johnglennII/Tomato-Harvester/cad/assembly/Arm Plate v2.SLDPRT

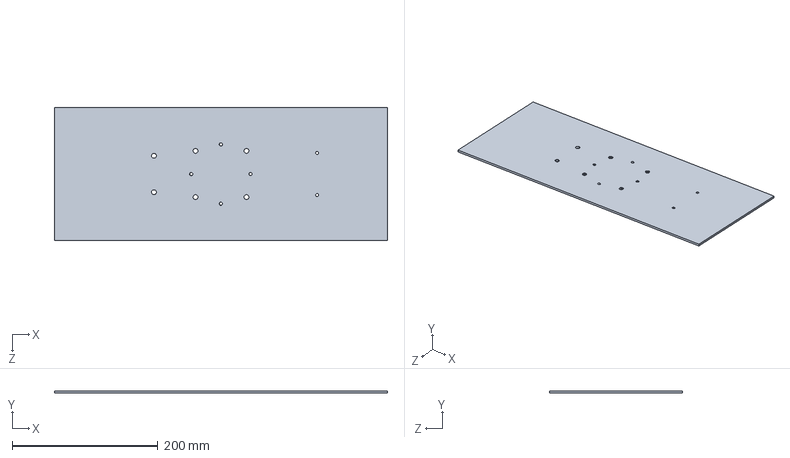
[picture p8: CAD file, 2026-05-16]
cad/assembly/Arm Plate v2.SLDPRT
457.2 x 3.18 x 182.6 mm
