johnglennII/Tomato-Harvester/cad/assembly/2525 Length=SupportH.SLDPRT

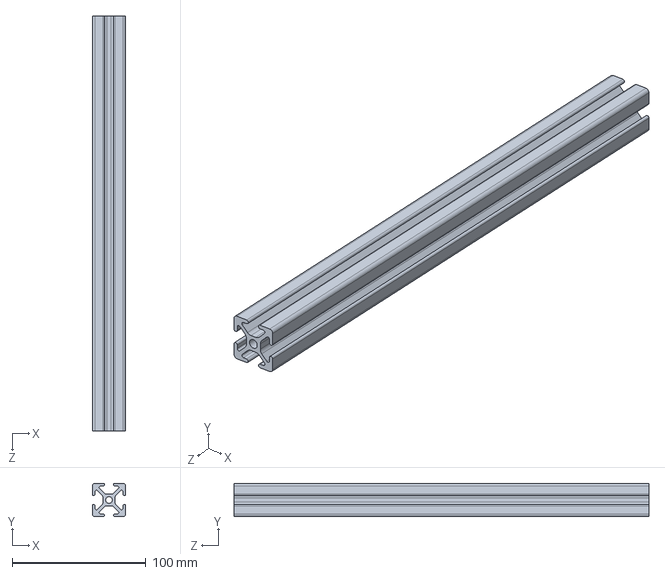
[picture p9: CAD file, 2026-05-16]
cad/assembly/2525 Length=SupportH.SLDPRT
25.0 x 25.0 x 310.8 mm
