johnglennII/Tomato-Harvester/cad/assembly/Turntable Support.SLDPRT

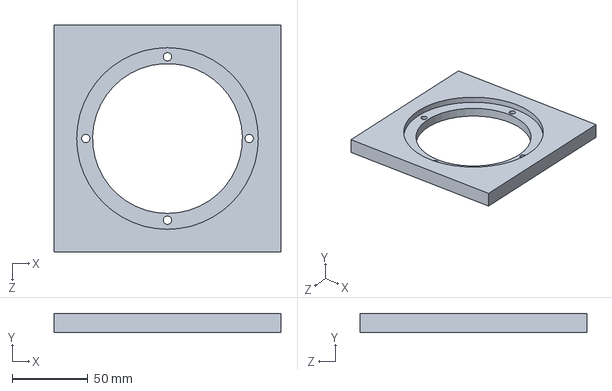
[picture p10: CAD file, 2026-05-16]
cad/assembly/Turntable Support.SLDPRT
150.0 x 12.6 x 150.0 mm
