johnglennII/Tomato-Harvester/cad/assembly/Phi Motor Support.SLDPRT

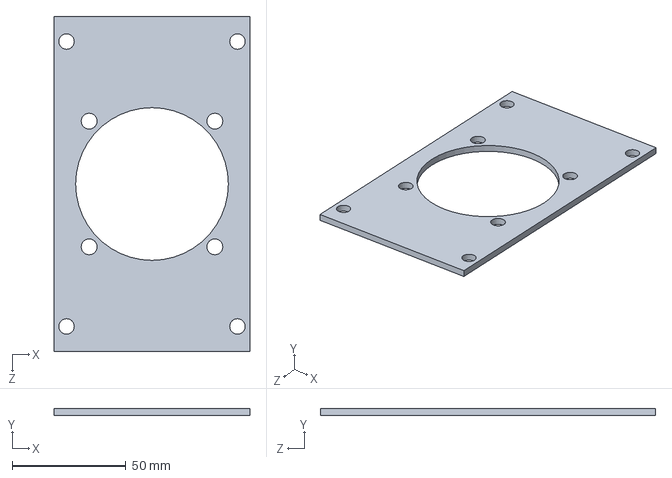
[picture p11: CAD file, 2026-05-16]
cad/assembly/Phi Motor Support.SLDPRT
86.0 x 3.17 x 147.0 mm
