johnglennII/Tomato-Harvester/cad/assembly/Turntable Bearing Outer.SLDPRT

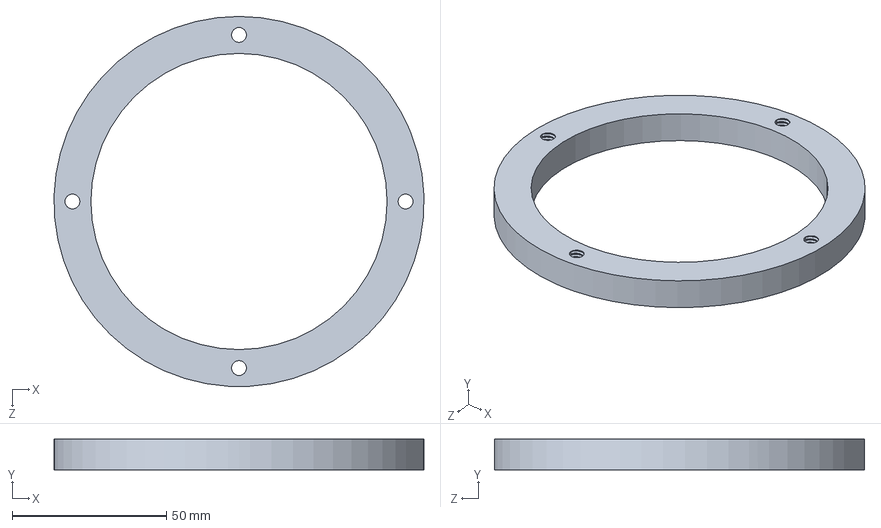
[picture p12: CAD file, 2026-05-16]
cad/assembly/Turntable Bearing Outer.SLDPRT
119.9 x 10.0 x 120.0 mm
