johnglennII/Tomato-Harvester/cad/assembly/Turntable Bearing Inner.SLDPRT

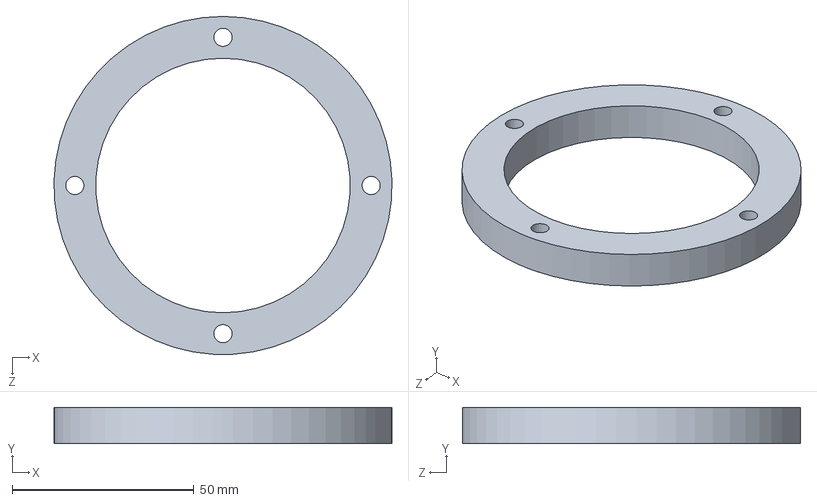
[picture p13: CAD file, 2026-05-16]
cad/assembly/Turntable Bearing Inner.SLDPRT
93.0 x 10.0 x 93.0 mm
