johnglennII/Tomato-Harvester/cad/assembly/Theta Shaft.SLDPRT

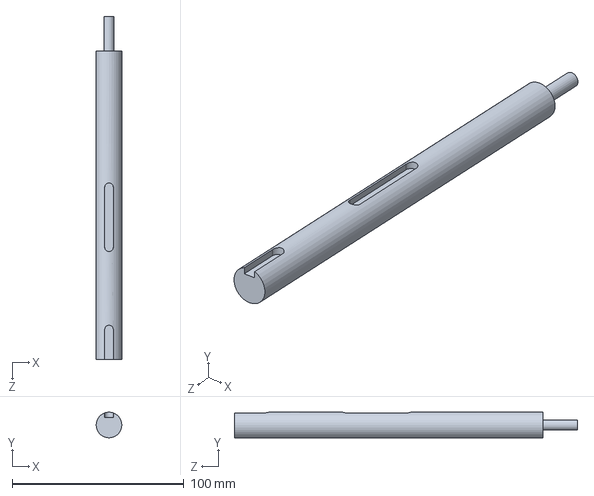
[picture p14: CAD file, 2026-05-16]
cad/assembly/Theta Shaft.SLDPRT
15.0 x 15.0 x 200.0 mm
