johnglennII/Tomato-Harvester/cad/assembly/Bottom Plate v2.SLDPRT

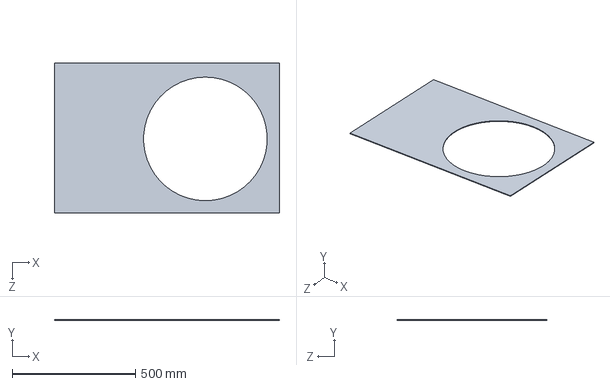
[picture p15: CAD file, 2026-05-16]
cad/assembly/Bottom Plate v2.SLDPRT
914.4 x 3.17 x 609.6 mm
