johnglennII/Tomato-Harvester/cad/assembly/Motor Mount.SLDPRT

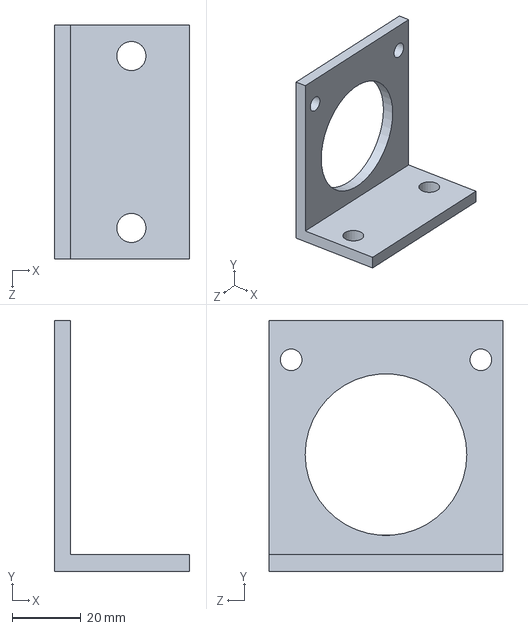
[picture p16: CAD file, 2026-05-16]
cad/assembly/Motor Mount.SLDPRT
39.4 x 73.0 x 68.0 mm
