johnglennII/Tomato-Harvester/cad/assembly/15mm Shaft Coupler.SLDPRT

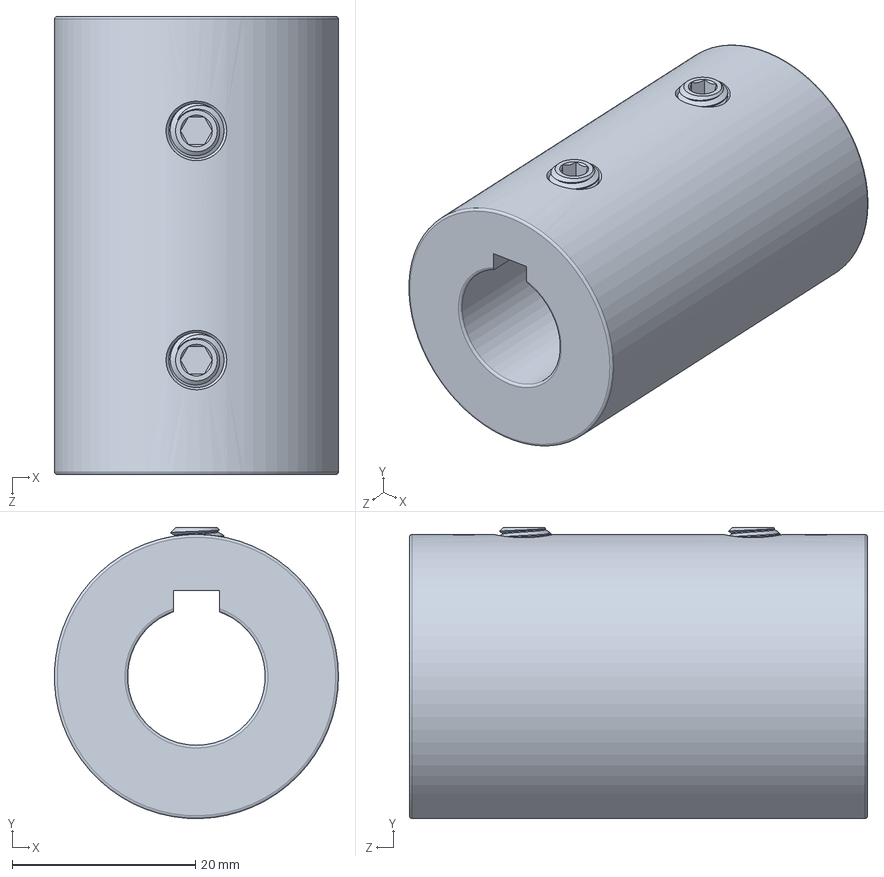
[picture p17: CAD file, 2026-05-16]
cad/assembly/15mm Shaft Coupler.SLDPRT
31.0 x 31.8 x 50.0 mm
