johnglennII/Tomato-Harvester/cad/assembly/Linear Actuator v3.SLDPRT

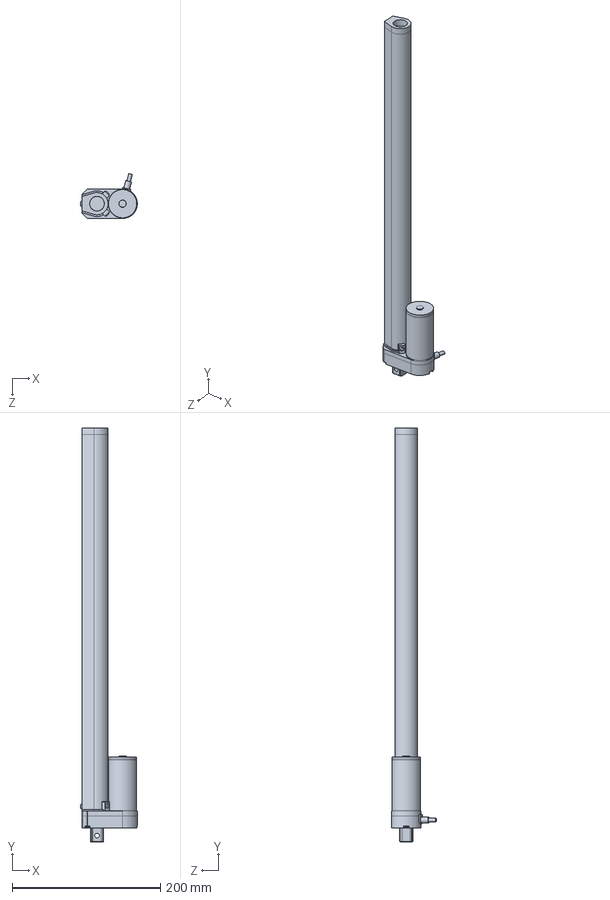
[picture p18: CAD file, 2026-05-16]
cad/assembly/Linear Actuator v3.SLDPRT
76.6 x 558.9 x 60.7 mm
