johnglennII/Tomato-Harvester/cad/assembly/Cytron MD10C R3.SLDPRT

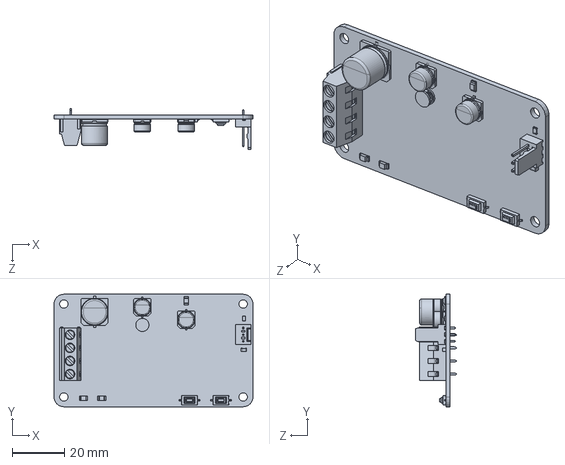
[picture p19: CAD file, 2026-05-16]
cad/assembly/Cytron MD10C R3.SLDPRT
76.0 x 43.0 x 15.7 mm
