johnglennII/Tomato-Harvester/cad/assembly/Motor Driver Box.SLDPRT

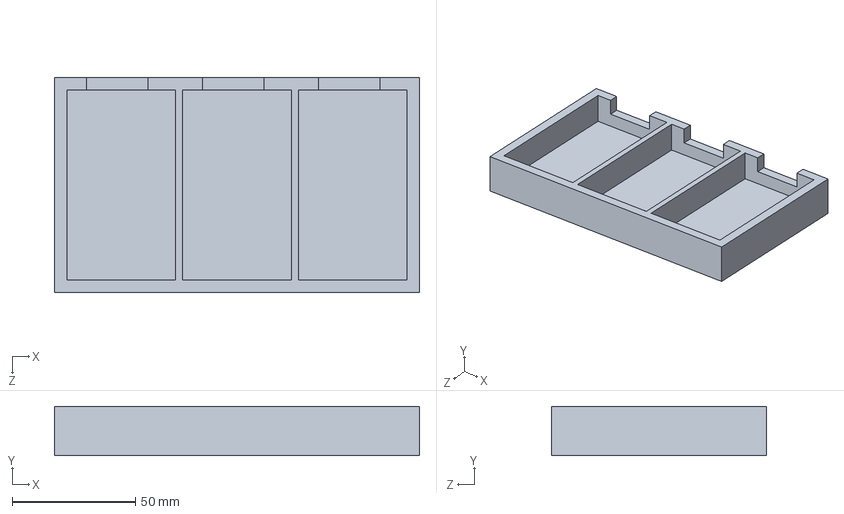
[picture p20: CAD file, 2026-05-15]
cad/assembly/Motor Driver Box.SLDPRT
148.0 x 20.0 x 87.0 mm
