johnglennII/Tomato-Harvester/cad/assembly/DC Motor 2 v2.SLDPRT

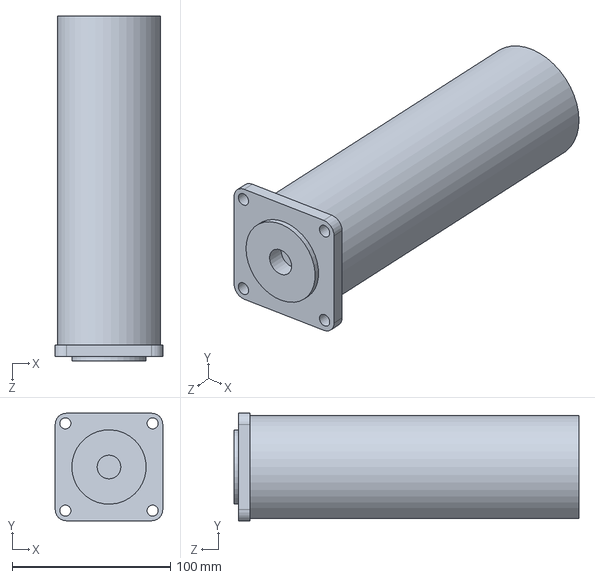
[picture p21: CAD file, 2026-05-15]
cad/assembly/DC Motor 2 v2.SLDPRT
68.0 x 68.0 x 218.0 mm
