johnglennII/Tomato-Harvester/cad/assembly/Actuator Adapter.SLDPRT

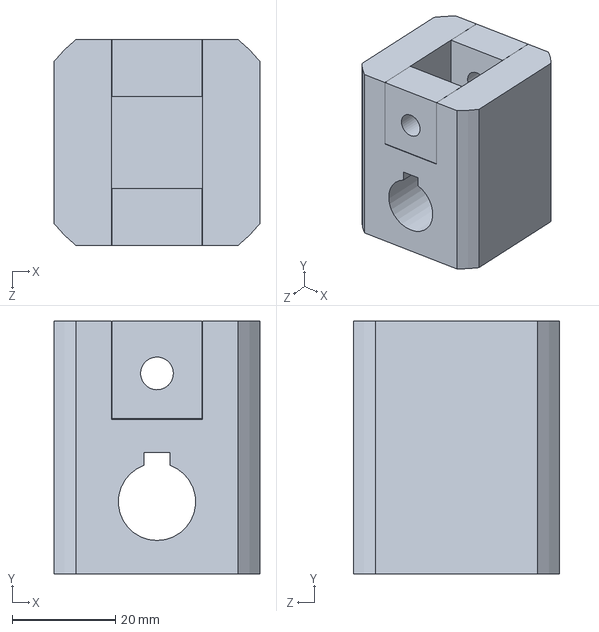
[picture p22: CAD file, 2026-05-15]
cad/assembly/Actuator Adapter.SLDPRT
39.9 x 49.0 x 39.9 mm
