johnglennII/Tomato-Harvester/cad/assembly/DC Motor Shaft 2 v2.SLDPRT

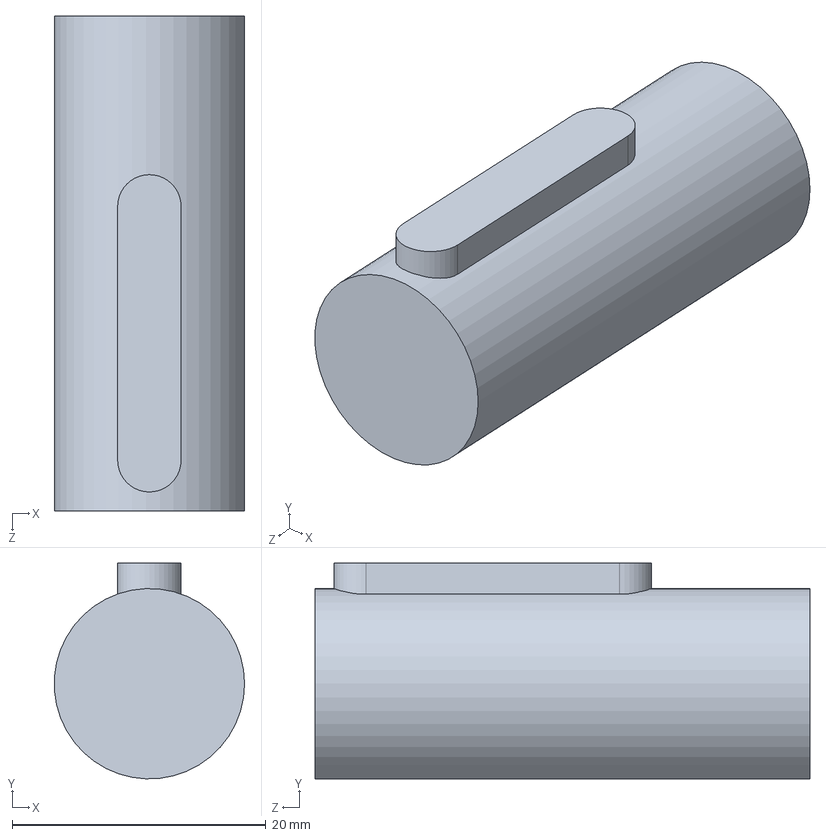
[picture p23: CAD file, 2026-05-15]
cad/assembly/DC Motor Shaft 2 v2.SLDPRT
15.0 x 17.0 x 39.0 mm
