johnglennII/Tomato-Harvester/cad/assembly/Draw Wire Encoder.SLDPRT

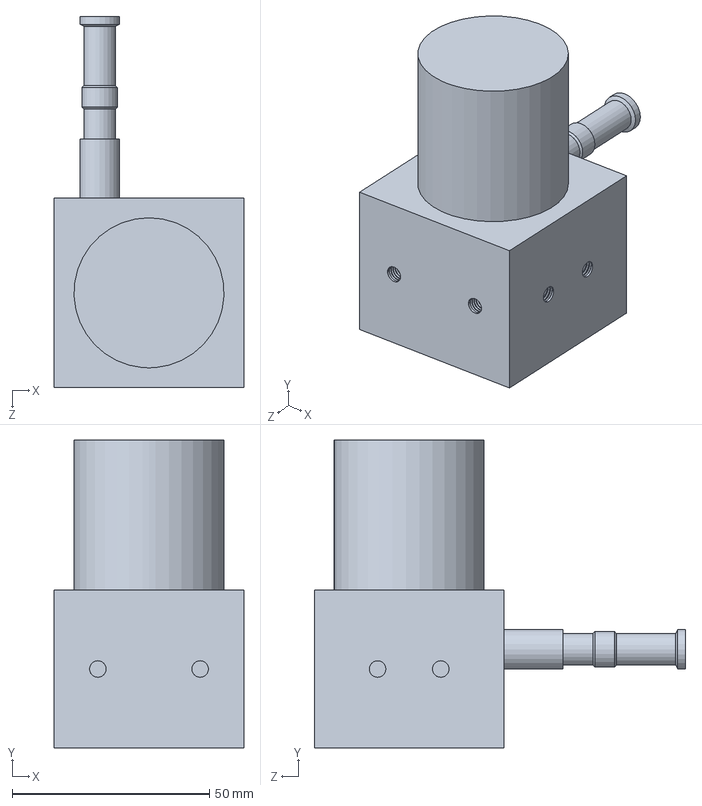
[picture p24: CAD file, 2026-05-15]
cad/assembly/Draw Wire Encoder.SLDPRT
48.0 x 78.0 x 94.0 mm
