johnglennII/Tomato-Harvester/cad/assembly/Draw Wire Encoder Bracket.SLDPRT

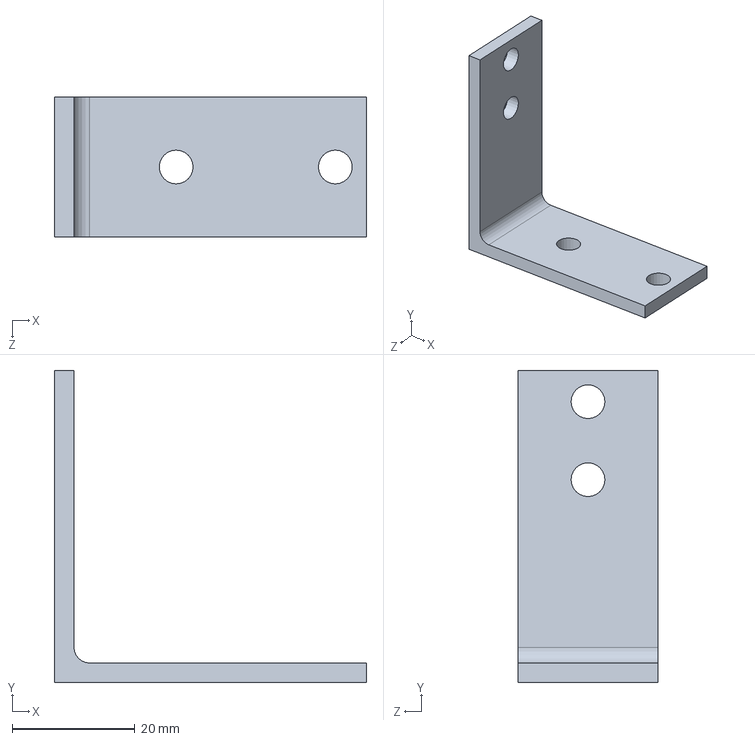
[picture p25: CAD file, 2026-05-15]
cad/assembly/Draw Wire Encoder Bracket.SLDPRT
50.8 x 50.8 x 22.9 mm
