johnglennII/Tomato-Harvester/cad/assembly/Breakout Board Box.SLDPRT

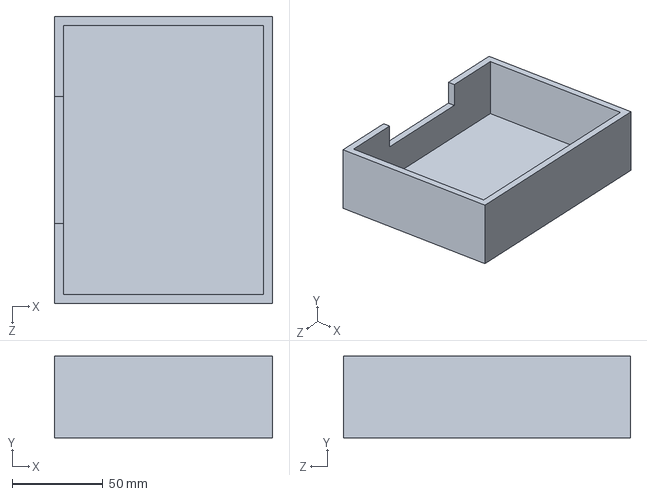
[picture p26: CAD file, 2026-05-15]
cad/assembly/Breakout Board Box.SLDPRT
120.0 x 45.0 x 158.0 mm
