johnglennII/Tomato-Harvester/cad/assembly/Phi Shaft.SLDPRT

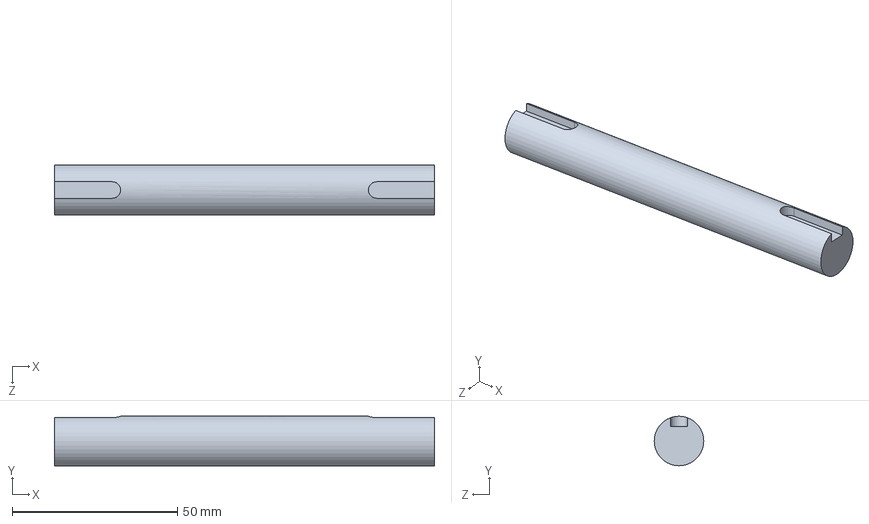
[picture p27: CAD file, 2026-05-15]
cad/assembly/Phi Shaft.SLDPRT
115.0 x 15.0 x 15.0 mm
