johnglennII/Tomato-Harvester/cad/assembly/Machined Shaft Coupler Top.SLDPRT

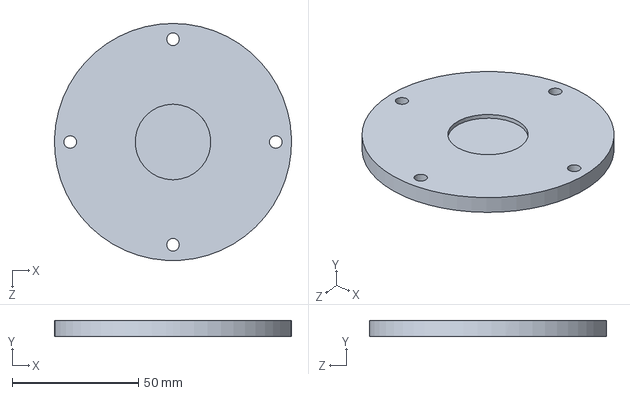
[picture p28: CAD file, 2026-05-15]
cad/assembly/Machined Shaft Coupler Top.SLDPRT
94.0 x 6.35 x 94.0 mm
