johnglennII/Tomato-Harvester/cad/assembly/Hollow Shaft Encoder.SLDPRT

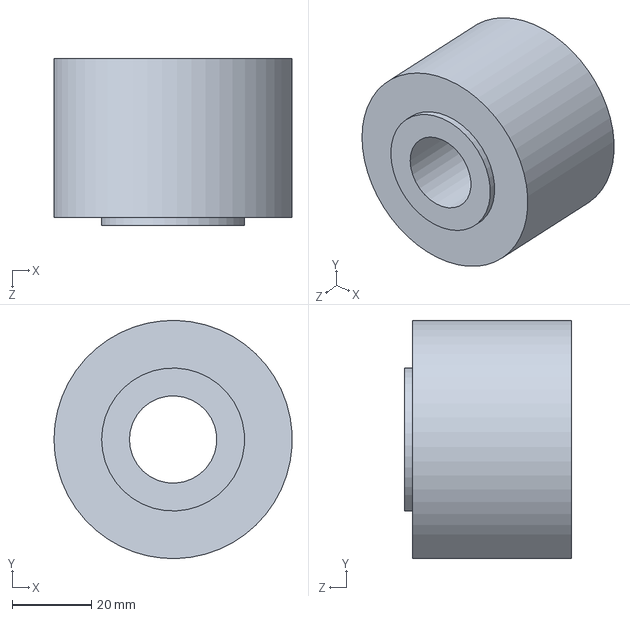
[picture p29: CAD file, 2026-05-15]
cad/assembly/Hollow Shaft Encoder.SLDPRT
59.9 x 60.0 x 42.0 mm
