johnglennII/Tomato-Harvester/cad/assembly/20mm Rounded Key.SLDPRT

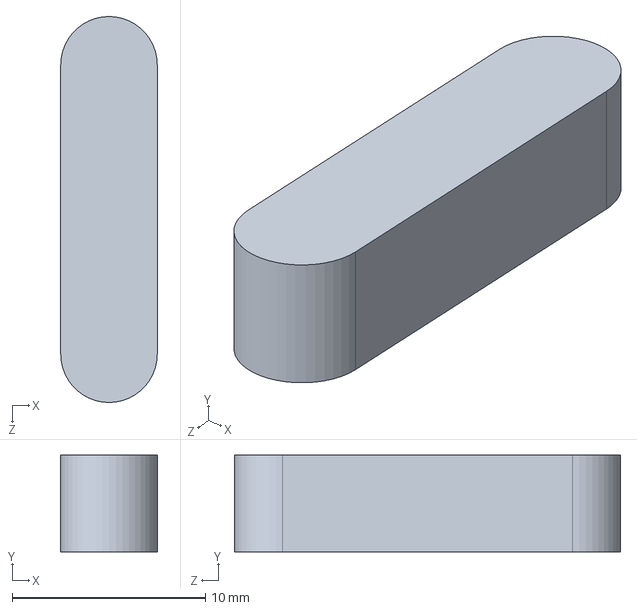
[picture p30: CAD file, 2026-05-15]
cad/assembly/20mm Rounded Key.SLDPRT
5.00 x 5.00 x 20.0 mm
