johnglennII/Tomato-Harvester/cad/assembly/6mm-6mm coupler.SLDPRT

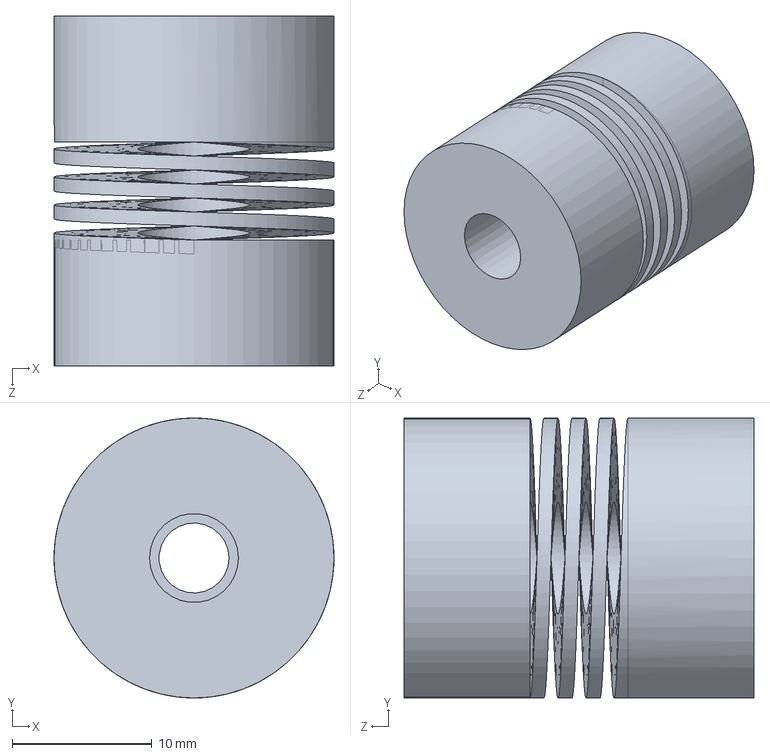
[picture p31: CAD file, 2026-05-15]
cad/assembly/6mm-6mm coupler.SLDPRT
20.0 x 20.0 x 25.0 mm
