johnglennII/Tomato-Harvester/cad/assembly/40mm Rounded Key.SLDPRT

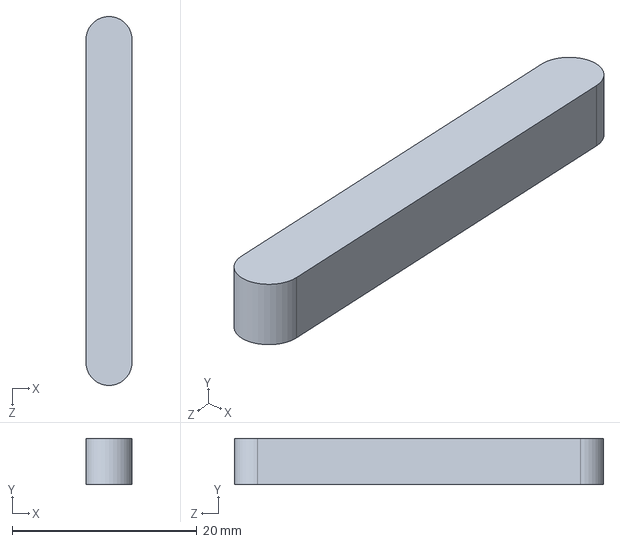
[picture p32: CAD file, 2026-05-15]
cad/assembly/40mm Rounded Key.SLDPRT
5.00 x 5.00 x 40.0 mm
