johnglennII/Tomato-Harvester/cad/assembly/Machined Shaft Coupler Bottom.SLDPRT

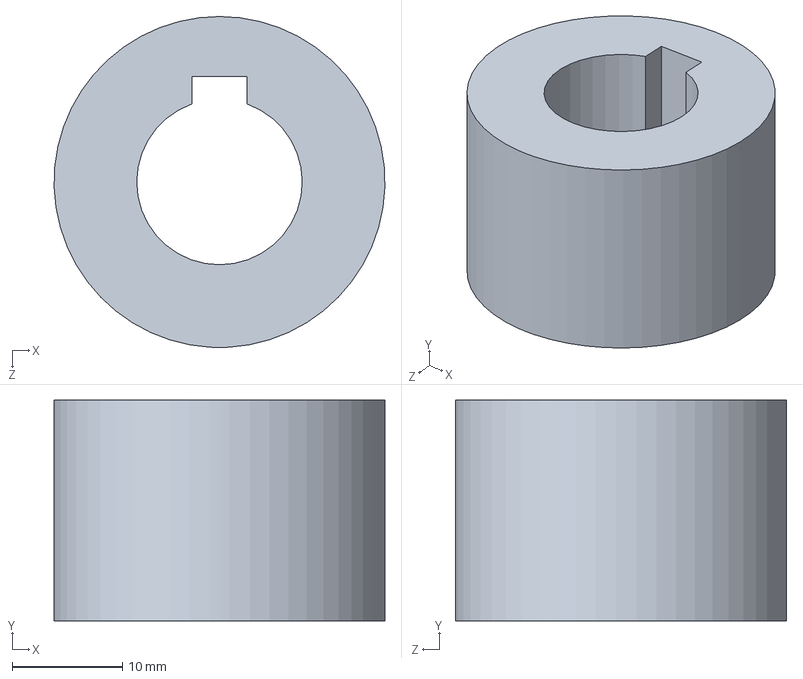
[picture p33: CAD file, 2026-05-15]
cad/assembly/Machined Shaft Coupler Bottom.SLDPRT
30.0 x 20.0 x 30.0 mm
