johnglennII/Tomato-Harvester/cad/assembly/Pillow Block Stand.SLDPRT

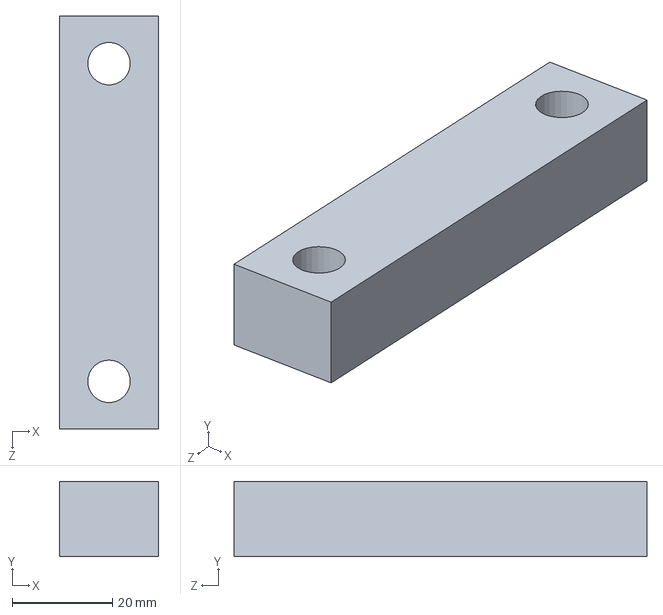
[picture p34: CAD file, 2026-05-15]
cad/assembly/Pillow Block Stand.SLDPRT
19.8 x 15.0 x 82.5 mm
