johnglennII/Tomato-Harvester/cad/assembly/Hollow Shaft.SLDPRT

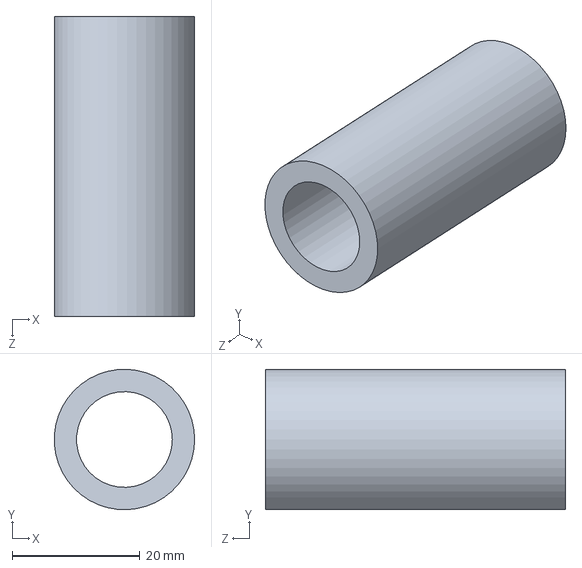
[picture p35: CAD file, 2026-05-15]
cad/assembly/Hollow Shaft.SLDPRT
22.0 x 22.0 x 47.0 mm
