johnglennII/Tomato-Harvester/cad/assembly/Rotary Encoder Housing.SLDPRT

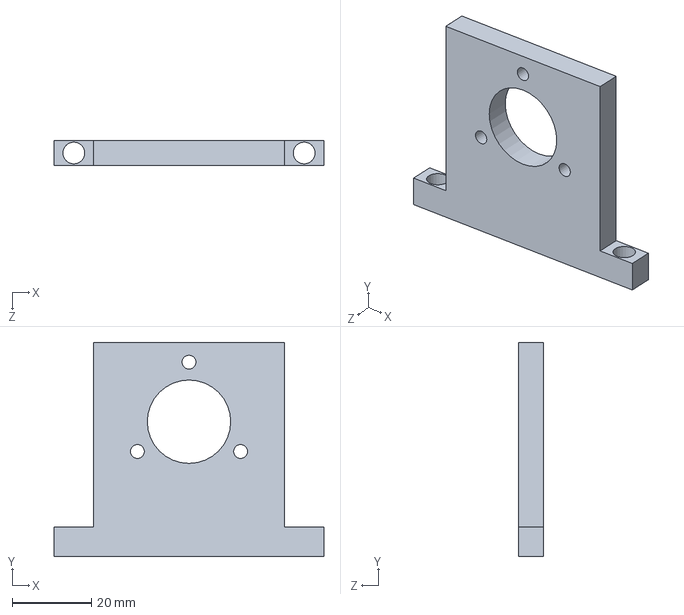
[picture p36: CAD file, 2026-05-15]
cad/assembly/Rotary Encoder Housing.SLDPRT
68.0 x 54.0 x 6.40 mm
