johnglennII/Tomato-Harvester/cad/assembly/Rotary Encoder Shaft v2.SLDPRT

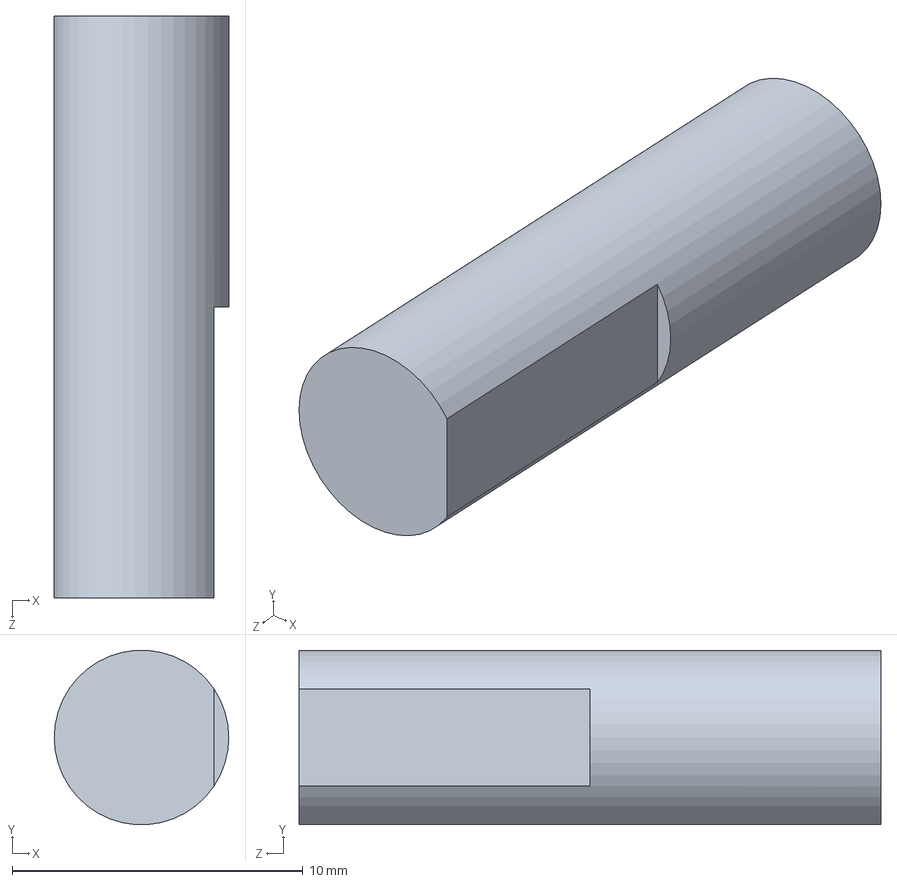
[picture p37: CAD file, 2026-05-15]
cad/assembly/Rotary Encoder Shaft v2.SLDPRT
6.00 x 5.98 x 20.0 mm
