johnglennII/Tomato-Harvester/cad/assembly/Linear Actuator Rod v3.SLDPRT

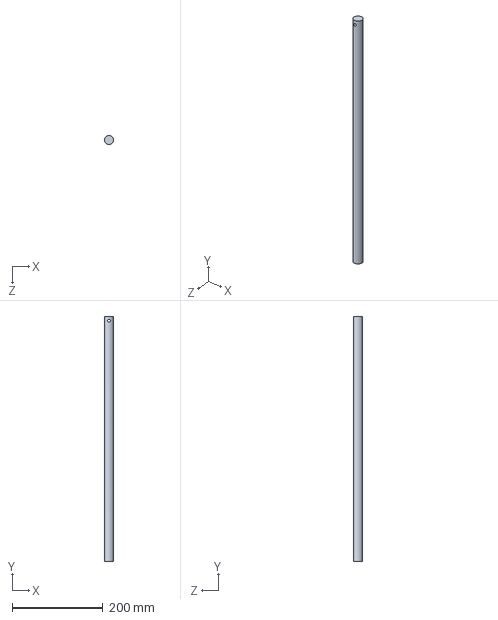
[picture p38: CAD file, 2026-05-15]
cad/assembly/Linear Actuator Rod v3.SLDPRT
19.8 x 539.8 x 19.8 mm
