johnglennII/Tomato-Harvester/cad/assembly/Rotary Encoder v2.SLDPRT

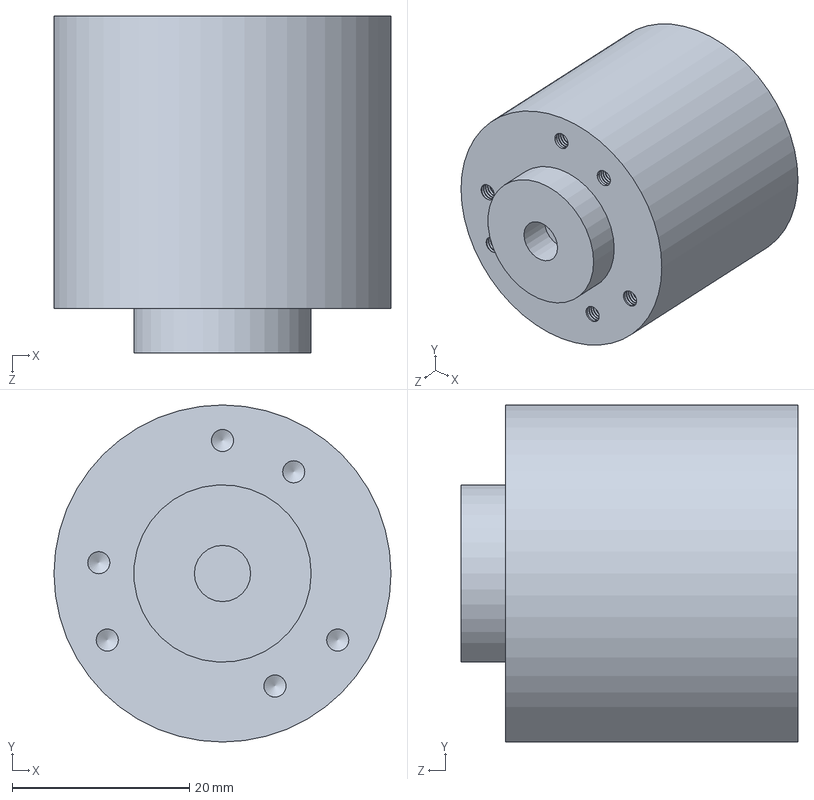
[picture p39: CAD file, 2026-05-15]
cad/assembly/Rotary Encoder v2.SLDPRT
38.0 x 38.0 x 38.0 mm
