johnglennII/Tomato-Harvester/(list of files, cad)

Other CAD files:
cad/assembly/2525 Length=SupportZ.SLDPRT
cad/assembly/2525 Length=BottomPlateX.SLDPRT
cad/assembly/2525 Length=Height.SLDPRT
cad/assembly/2525 Length=BottomPlateZ.SLDPRT
cad/assembly/Corner Bracket.SLDPRT
cad/assembly/2820T56_Dry-Running Mounted Sleeve Bearing.SLDPRT
cad/assembly/M3x0.5-12.SLDPRT
cad/assembly/M5x0.8-10.SLDPRT
cad/assembly/M5x0.8-18.SLDPRT
cad/assembly/M7 Nut.SLDPRT
cad/assembly/M7x1-20.SLDPRT
cad/assembly/M8x1.25-25.SLDPRT
