johnglennII/Tomato-Harvester/media/cad_assembly_1.png

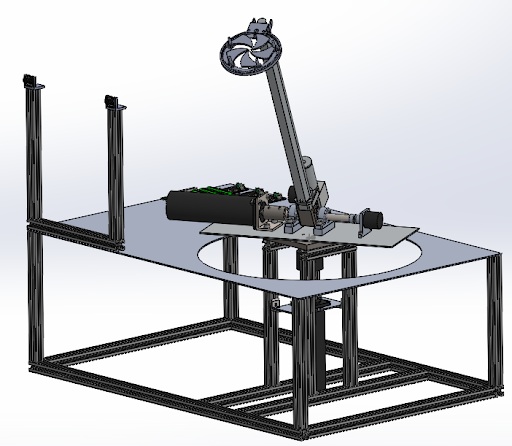
media/cad_assembly_1.png
