johnglennII/Tomato-Harvester/docs/harvester_scratchwork.pdf

I F

m | mi | -

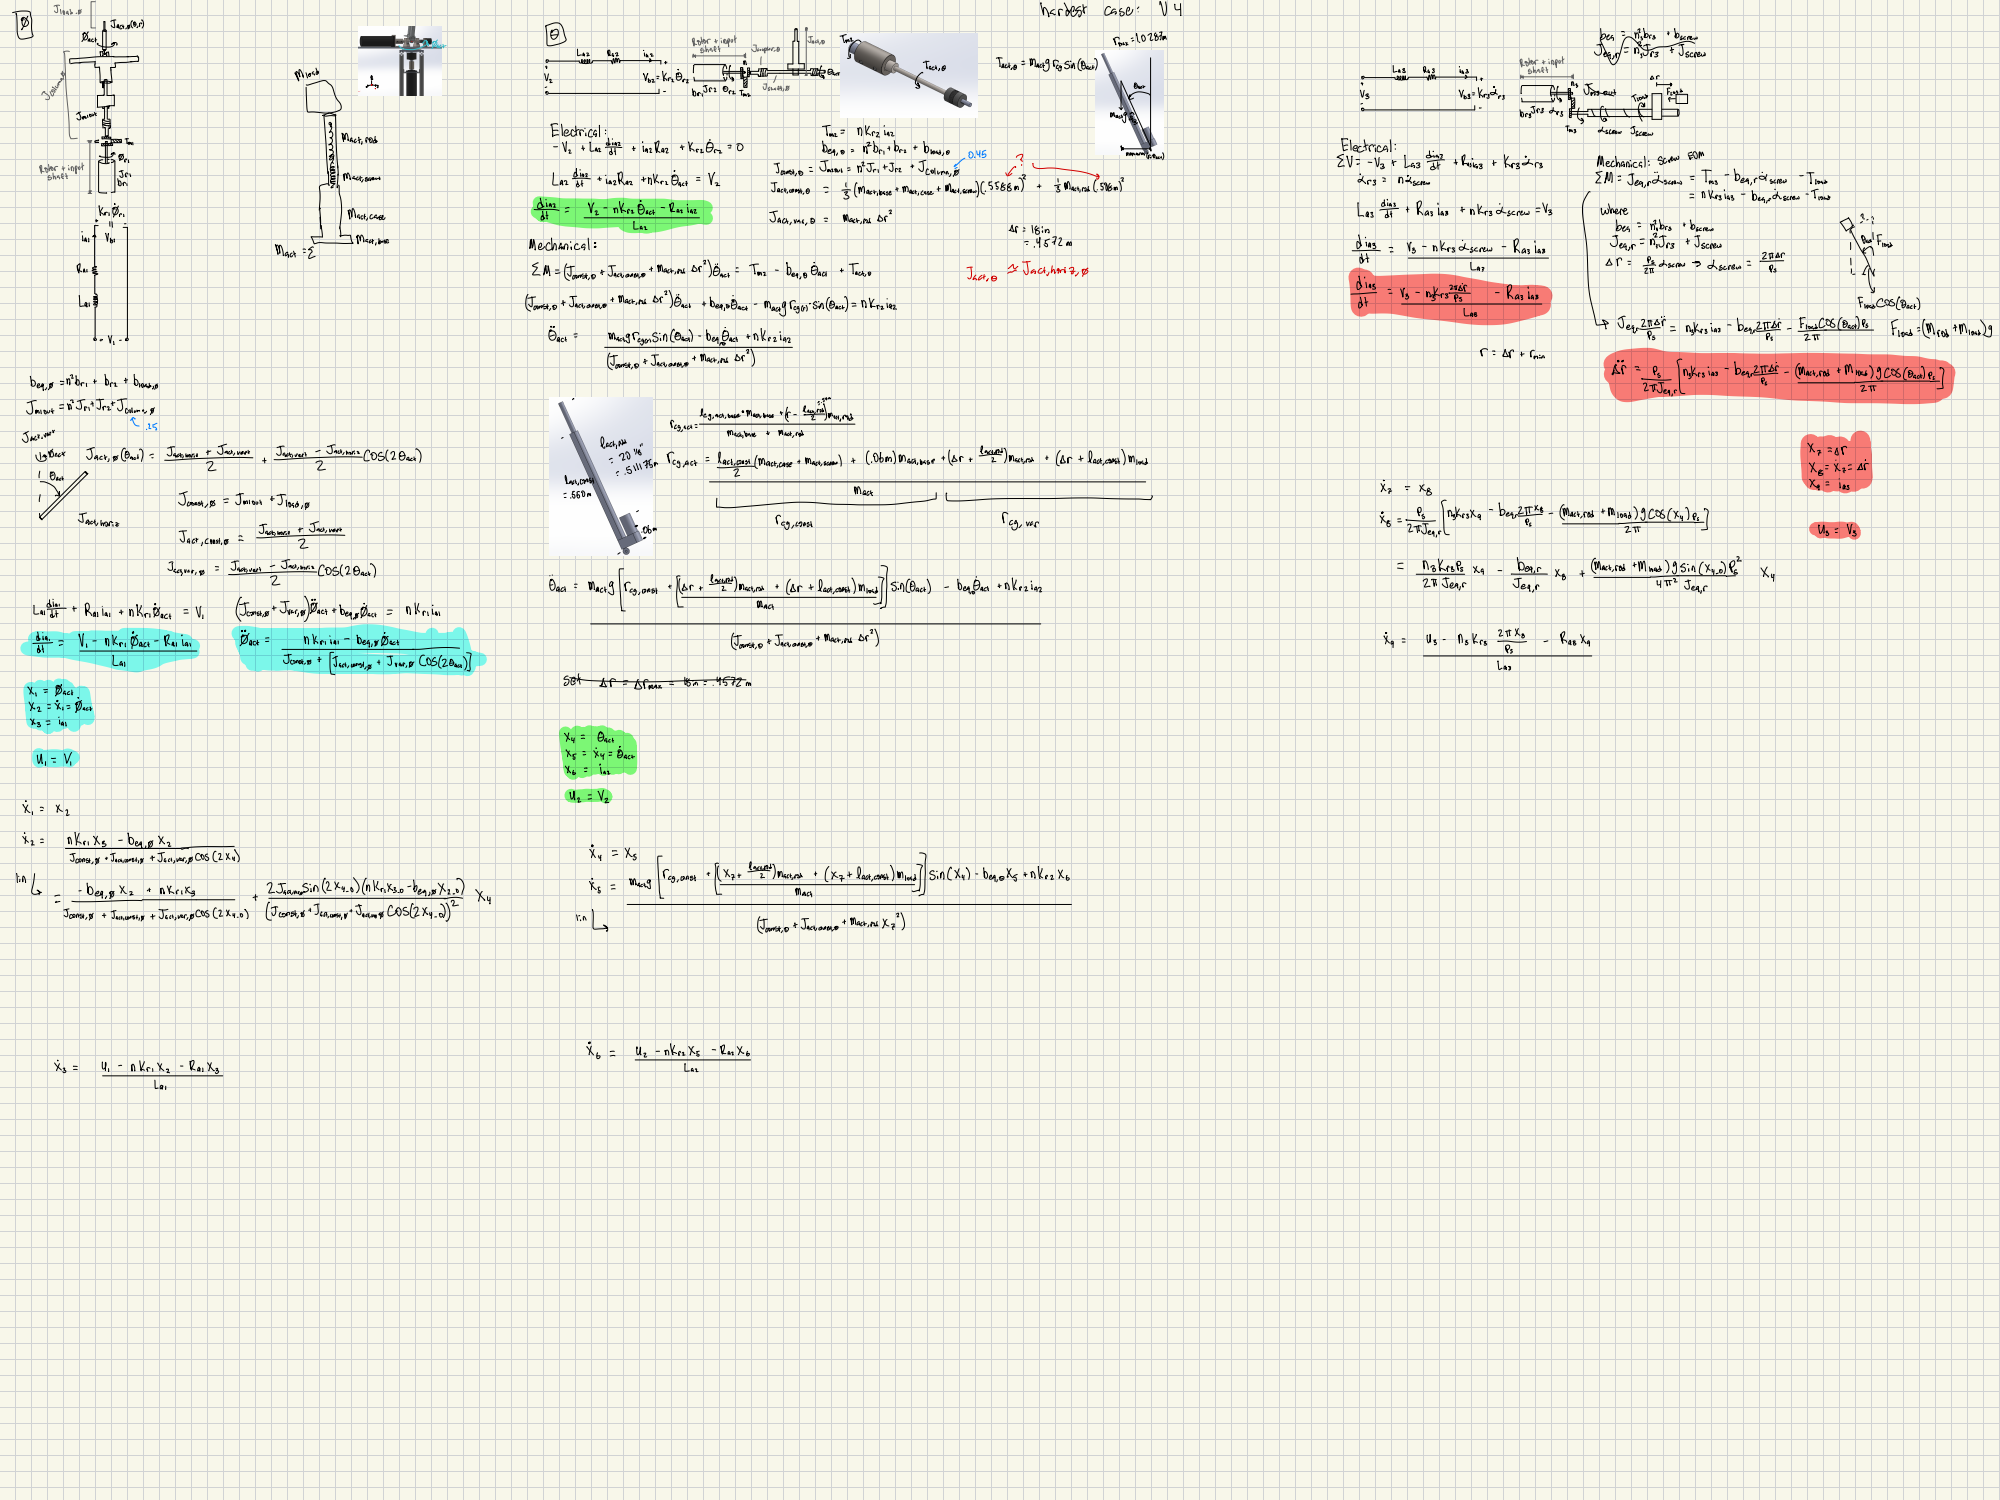
[picture p41: page 1]
Jload ,; hardest; case; Dact; = Jact,a(0,r); Rotor +; inpot; -Fact,O; Umax =; bes; "brs; bscrew; ~Dact; shaft; ↑ Laz; Tcoupler,O; TJrs; + Jscrew; -"Fact; Va = Knee !; Tact,; Tact,o; Mact9 Tey Sin (Fact); Rotor + inpot; Jrz; Orz; Vos = KrzIrs; Tout; load ² ·sy; Jshaft,; fact; bri; Tioal; mag; braJos CrsE6; -Tmi; + Laz; ia2Raz; KraErz =; Electrical :; Tmz =; NKrzia; Iscrew Jscrew; =Dri; bego; Abri ⁺ bra; bloc,; momarm (r.act); Laz + Rasians; Krgrs; Mechanical :; Screw; FOM; Jri; Tconst =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

= Us-nKryscrew-Rasias

Const,
of Jacksonst,
of Jacksonst,o+ Macr,ros Dr)Fact + beg,

=P Mksias-begr-Castrod +

act, base "Mact, base +-Crosmast,

Jact, noriz COS(2 Fact
