johnglennII/Tomato-Harvester/docs/shop_drawings.pdf

D
D

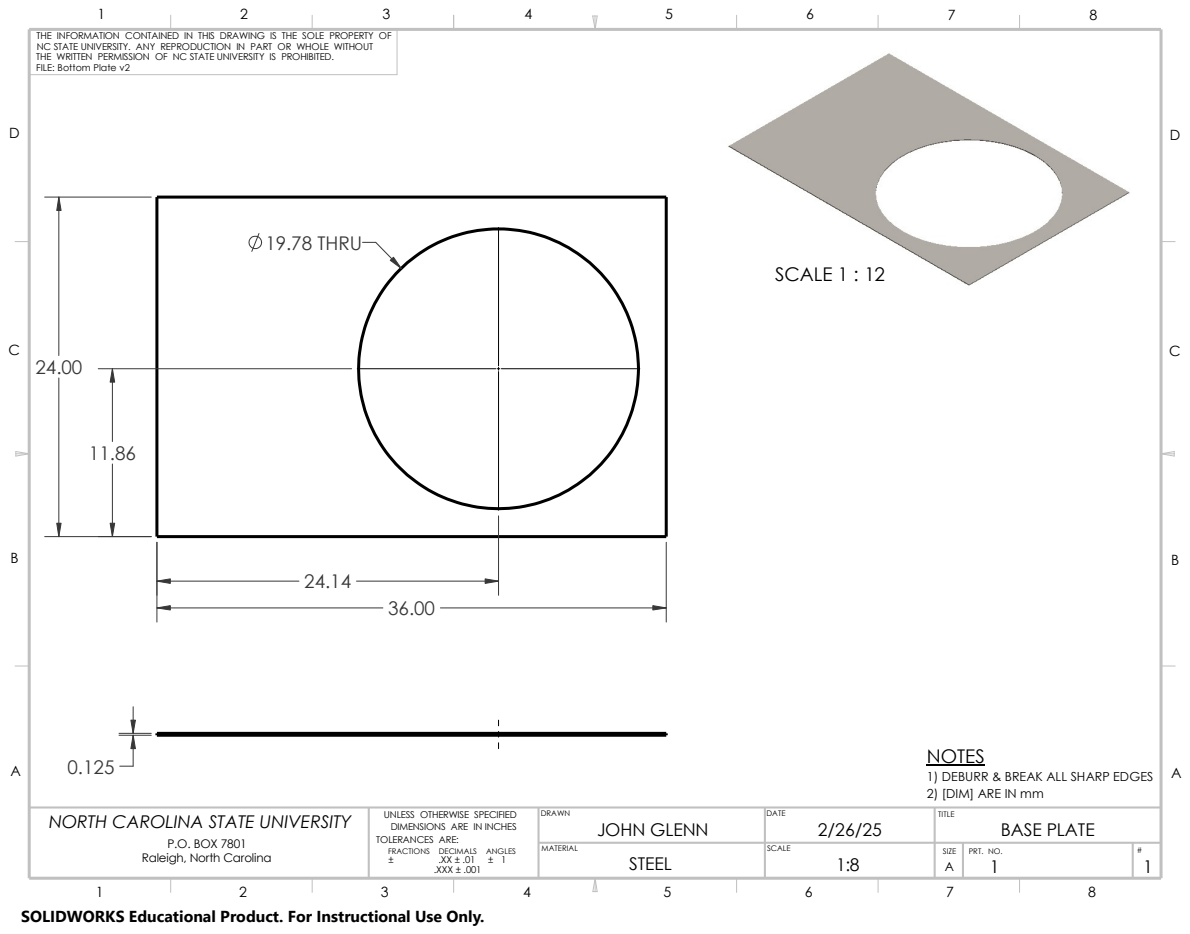
[picture p42: page 1]
SCALE 1 : 12; 19.78 THRU

THE INFORMATION CONTAINED IN THIS DRAWING IS THE SOLE PROPERTY OF
NC STATE UNIVERSITY. ANY REPRODUCTION IN PART OR WHOLE WITHOUT
THE WRITTEN PERMISSION OF NC STATE UNIVERSITY IS PROHIBITED.
FILE: Bottom Plate v2

NOTES
1) DEBURR & BREAK ALL SHARP EDGES
2) [DIM] ARE IN mm

P.O. BOX 7801 Raleigh, North Carolina | UNLESS OTHERWISE SPECIFIED NORTH CAROLINA STATE UNIVERSITY DIMENSIONS ARE IN INCHES TOLERANCES ARE: FRACTIONS DECIMALS ANGLES ± .XX ± .01 ± 1 .XXX ± .001 | DRAWN JOHN GLENN | DATE 2/26/25 | TITLE BASE PLATE

MATERIAL STEEL | SCALE 1:8 | SIZE A 1 | PRT. NO. | # 1

SOLIDWORKS Educational Product. For Instructional Use Only.

D
D

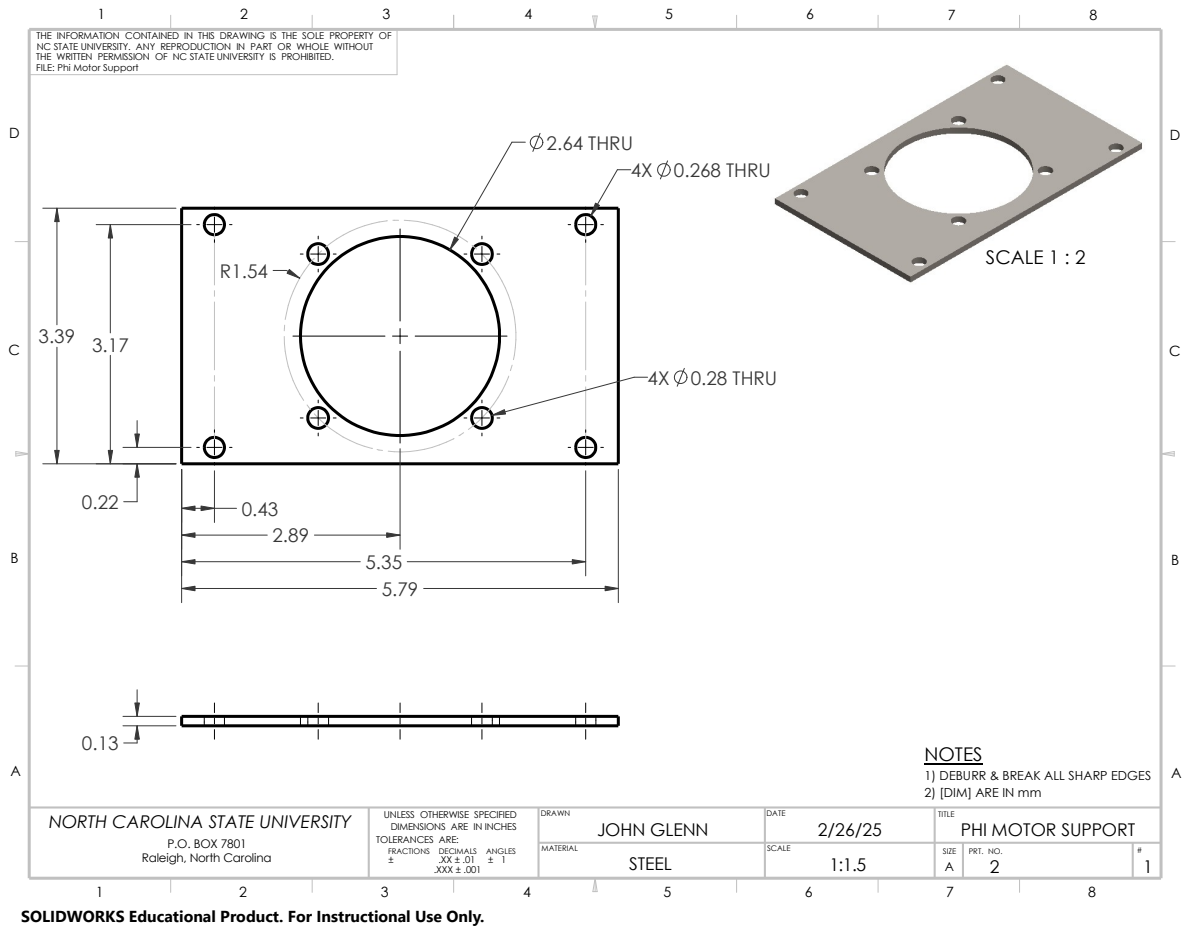
[picture p43: page 2]
SCALE 1 : 2; 2.64 THRU 4X 0.268 THRU; 4X 0.28 THRU

THE WRITTEN PERMISSION OF NC STATE UNIVERSITY IS PROHIBITED.
FILE: Phi Motor Support

NOTES
1) DEBURR & BREAK ALL SHARP EDGES
2) [DIM] ARE IN mm

P.O. BOX 7801 | UNLESS OTHERWISE SPECIFIED NORTH CAROLINA STATE UNIVERSITY DIMENSIONS ARE IN INCHES TOLERANCES ARE: FRACTIONS DECIMALS ANGLES | DRAWN JOHN GLENN | DATE 2/26/25 | TITLE PHI MOTOR SUPPORT

MATERIAL | SCALE 1:1.5 | SIZE A 2 | PRT. NO. | #

R2.126

D

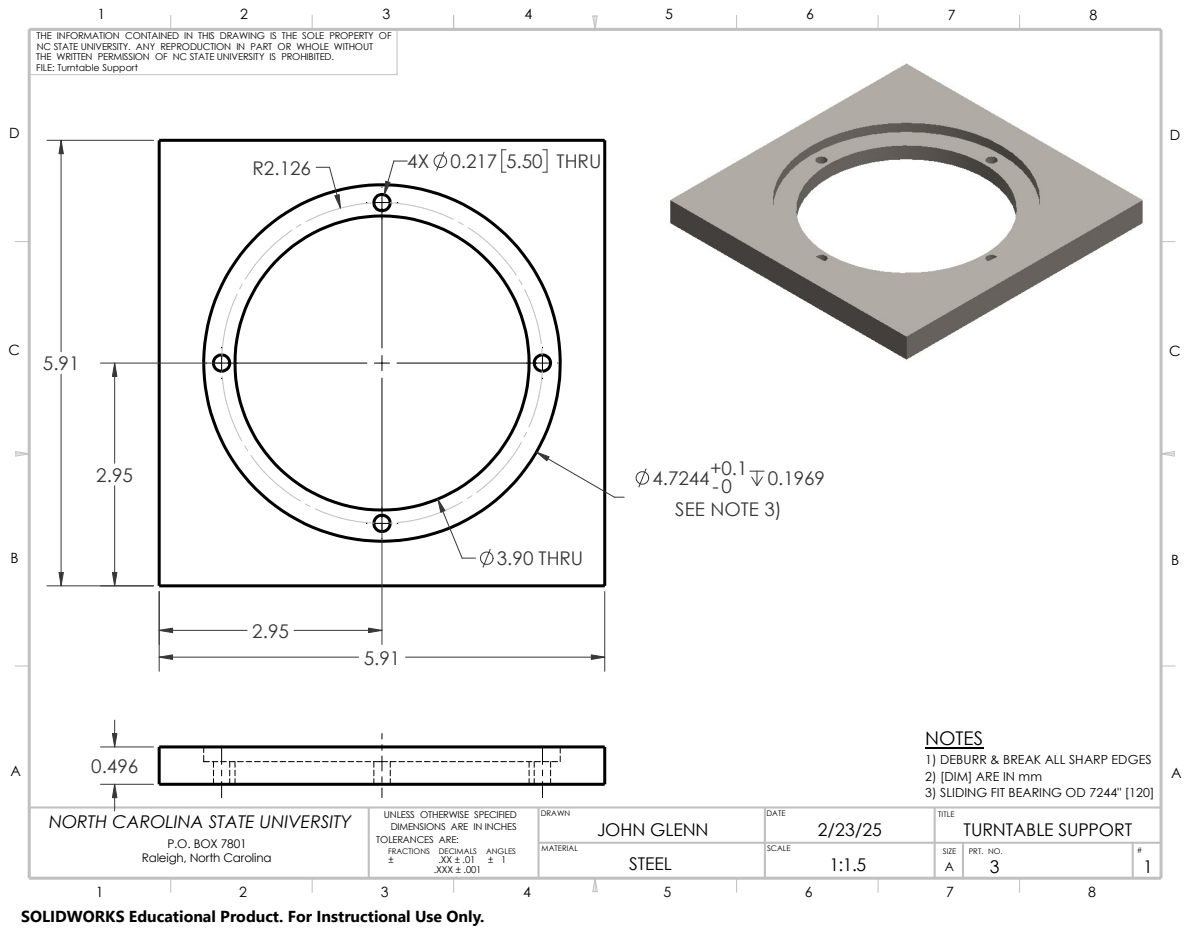
[picture p44: page 3]
0.1969 SEE NOTE 3); 3.90 THRU; THRU

THE WRITTEN PERMISSION OF NC STATE UNIVERSITY IS PROHIBITED.
FILE: Turntable Support

NOTES
1) DEBURR & BREAK ALL SHARP EDGES
2) [DIM] ARE IN mm
3) SLIDING FIT BEARING OD 7244" [120]

P.O. BOX 7801 | UNLESS OTHERWISE SPECIFIED NORTH CAROLINA STATE UNIVERSITY DIMENSIONS ARE IN INCHES TOLERANCES ARE: FRACTIONS DECIMALS ANGLES | DRAWN JOHN GLENN | DATE 2/23/25 | TITLE TURNTABLE SUPPORT

MATERIAL | SCALE 1:1.5 | SIZE A 3 | PRT. NO. | #

D
D

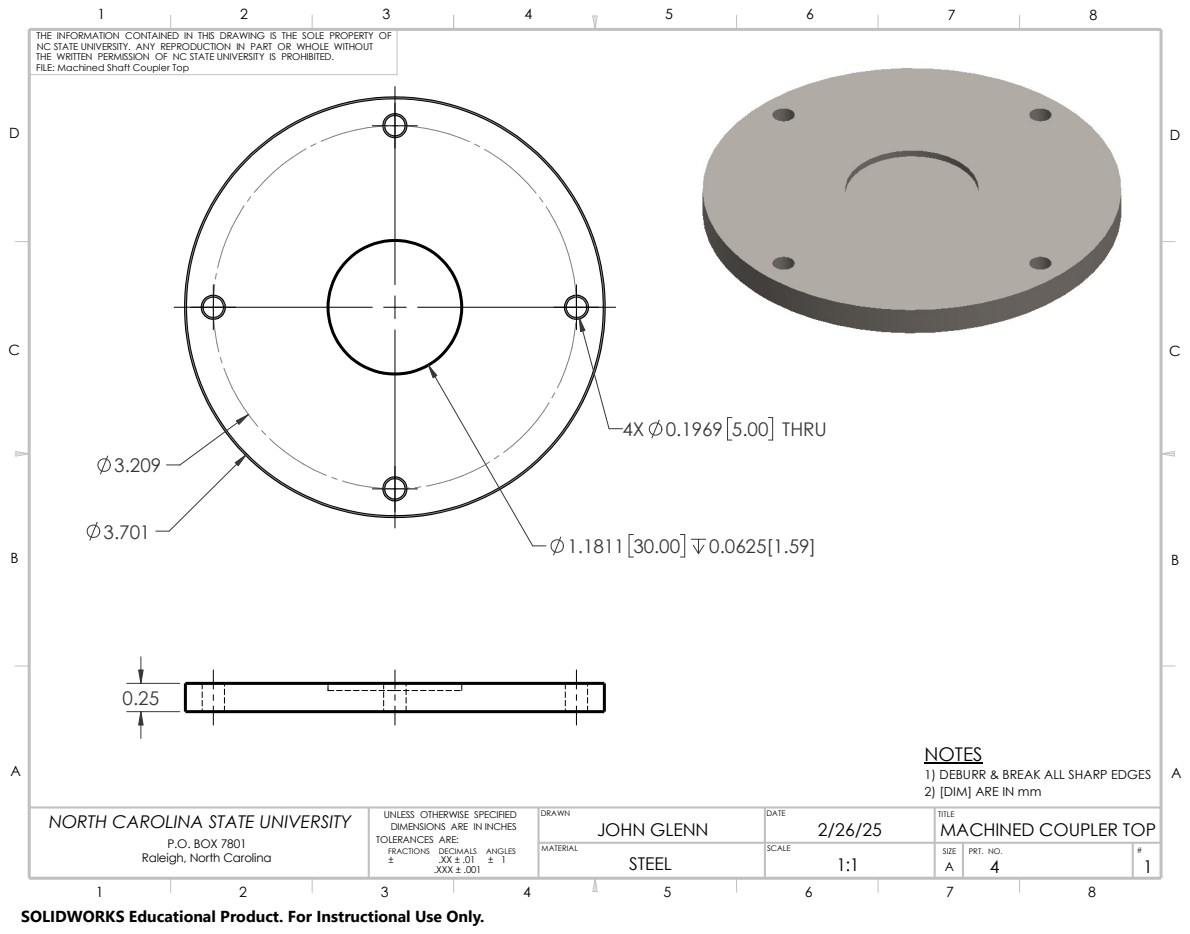
[picture p45: page 4]
THRU

THE WRITTEN PERMISSION OF NC STATE UNIVERSITY IS PROHIBITED.
FILE: Machined Shaft Coupler Top

NOTES
1) DEBURR & BREAK ALL SHARP EDGES
2) [DIM] ARE IN mm

P.O. BOX 7801 | UNLESS OTHERWISE SPECIFIED NORTH CAROLINA STATE UNIVERSITY DIMENSIONS ARE IN INCHES TOLERANCES ARE: FRACTIONS DECIMALS ANGLES | DRAWN JOHN GLENN | DATE 2/26/25 | TITLE MACHINED COUPLER TOP

MATERIAL | SCALE 1:1 | SIZE A 4 | PRT. NO. | #

D
D

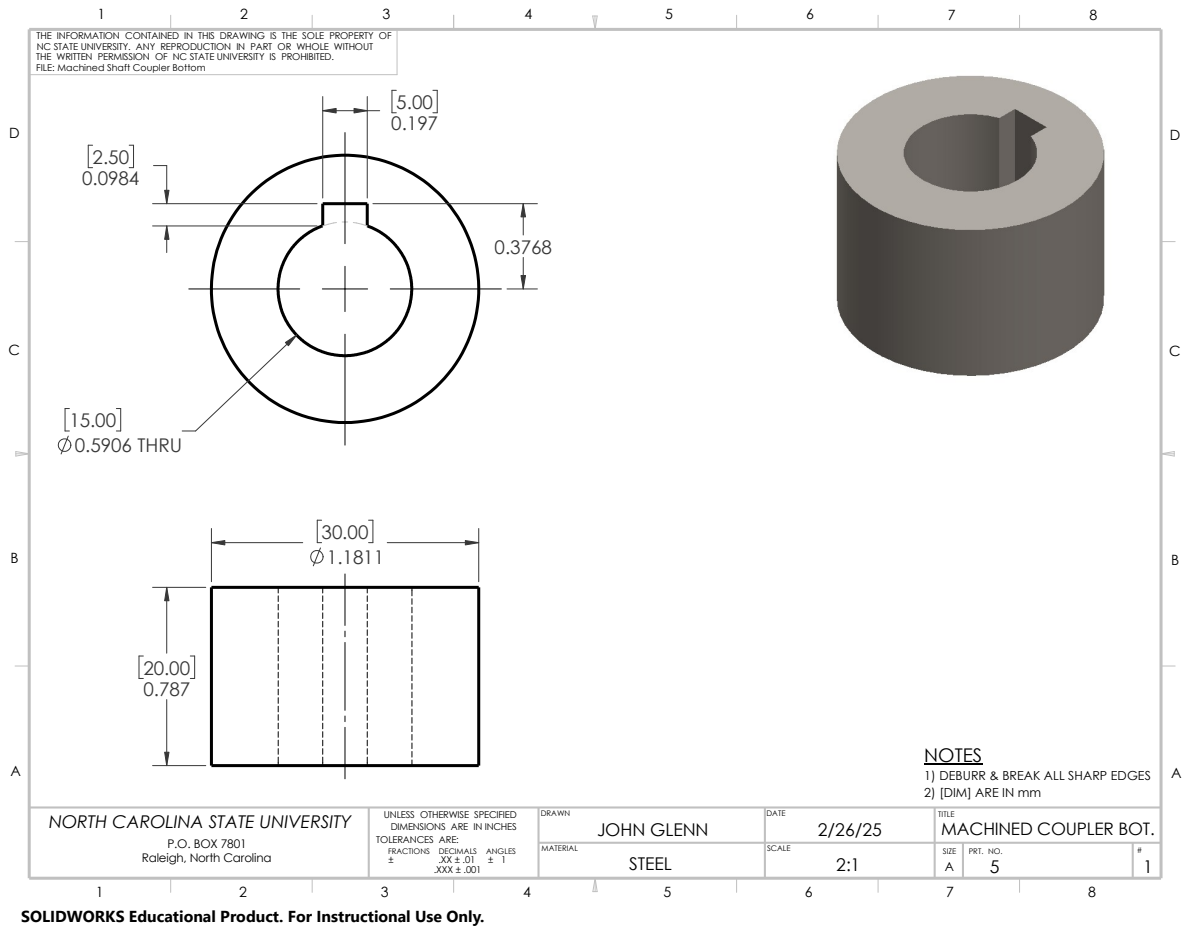
[picture p46: page 5]
15.00 0.5906 THRU

THE WRITTEN PERMISSION OF NC STATE UNIVERSITY IS PROHIBITED.
FILE: Machined Shaft Coupler Bottom

NOTES
1) DEBURR & BREAK ALL SHARP EDGES
2) [DIM] ARE IN mm

P.O. BOX 7801 | UNLESS OTHERWISE SPECIFIED NORTH CAROLINA STATE UNIVERSITY DIMENSIONS ARE IN INCHES TOLERANCES ARE: FRACTIONS DECIMALS ANGLES | DRAWN JOHN GLENN | DATE 2/26/25 | TITLE MACHINED COUPLER BOT.

MATERIAL | SCALE 2:1 | SIZE A 5 | PRT. NO. | #

D
D

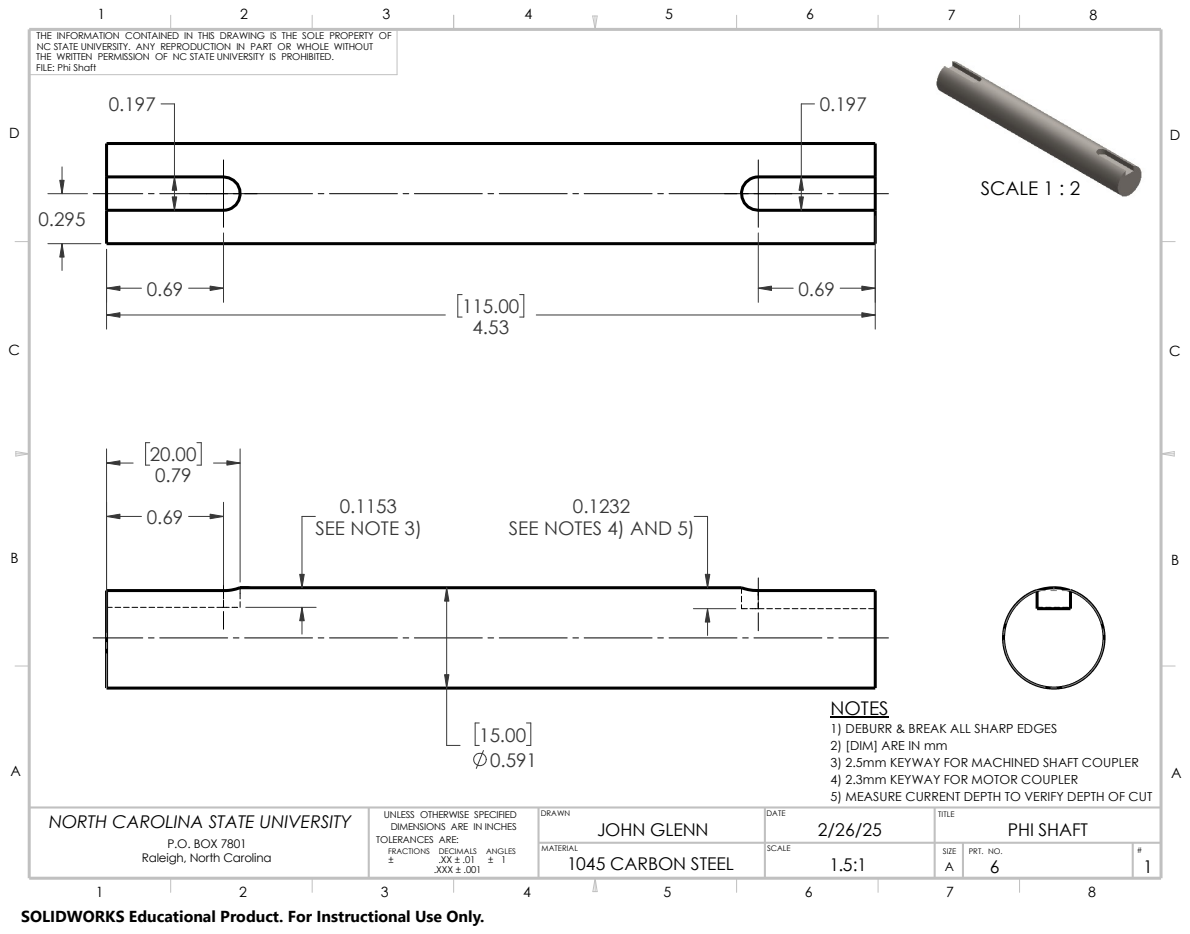
[picture p47: page 6]
SCALE 1 : 2; 0.1153 SEE NOTE 3)

THE WRITTEN PERMISSION OF NC STATE UNIVERSITY IS PROHIBITED.
FILE: Phi Shaft

SEE NOTES 4) AND 5)

NOTES
1) DEBURR & BREAK ALL SHARP EDGES
2) [DIM] ARE IN mm
3) 2.5mm KEYWAY FOR MACHINED SHAFT COUPLER
4) 2.3mm KEYWAY FOR MOTOR COUPLER
5) MEASURE CURRENT DEPTH TO VERIFY DEPTH OF CUT

P.O. BOX 7801 | UNLESS OTHERWISE SPECIFIED NORTH CAROLINA STATE UNIVERSITY DIMENSIONS ARE IN INCHES TOLERANCES ARE: FRACTIONS DECIMALS ANGLES | DRAWN JOHN GLENN | DATE 2/26/25 | TITLE PHI SHAFT

MATERIAL 1045 CARBON STEEL | SCALE 1.5:1 | SIZE A 6 | PRT. NO. | #

D
D

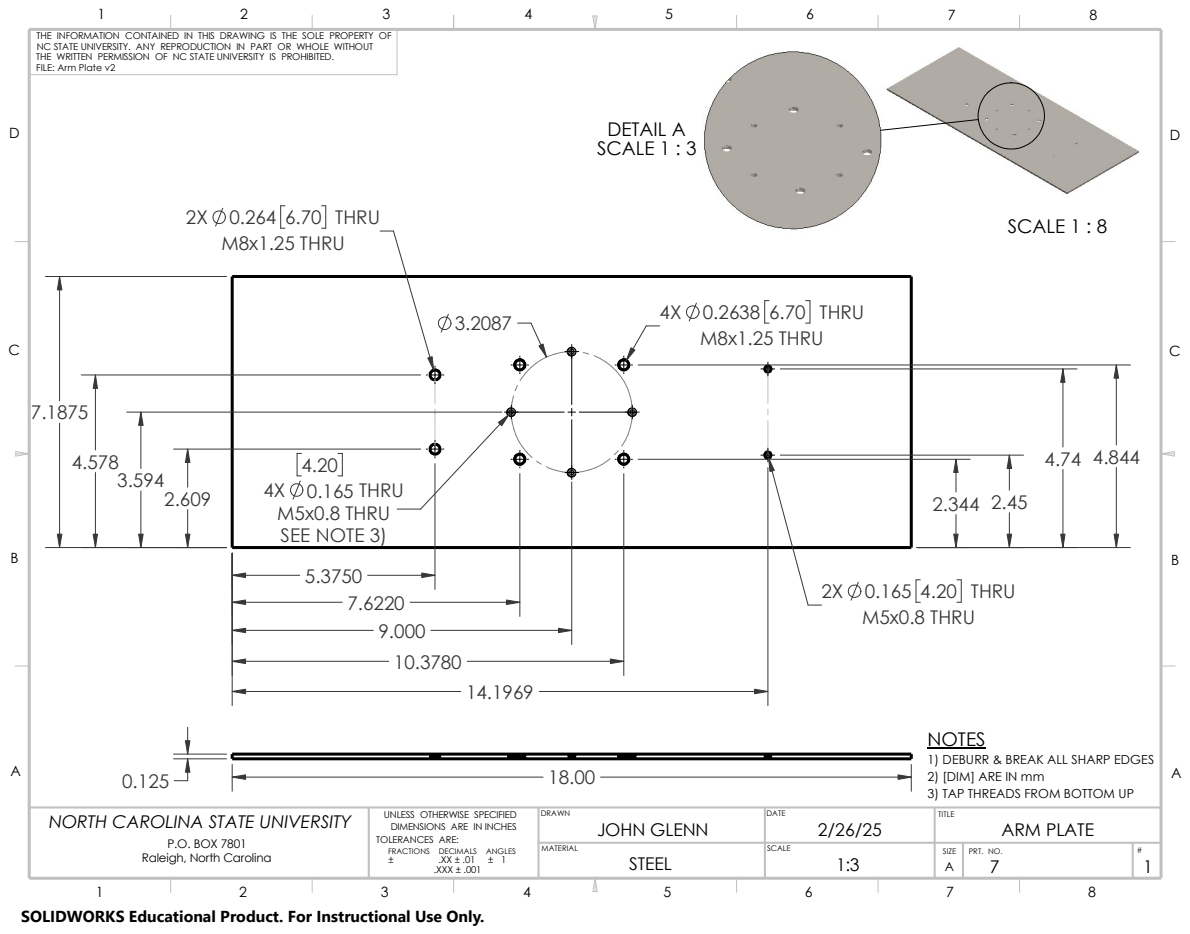
[picture p48: page 7]
DETAIL A SCALE 1 : 3; SCALE 1 : 8; THRU; M8x1.25 THRU; 4.20 0.165 THRU M5x0.8 THRU SEE NOTE 3); M5x0.8 THRU

THE WRITTEN PERMISSION OF NC STATE UNIVERSITY IS PROHIBITED.
FILE: Arm Plate v2

NOTES
1) DEBURR & BREAK ALL SHARP EDGES
2) [DIM] ARE IN mm
3) TAP THREADS FROM BOTTOM UP

P.O. BOX 7801 | UNLESS OTHERWISE SPECIFIED NORTH CAROLINA STATE UNIVERSITY DIMENSIONS ARE IN INCHES TOLERANCES ARE: FRACTIONS DECIMALS ANGLES | DRAWN JOHN GLENN | DATE 2/26/25 | TITLE ARM PLATE

MATERIAL | SCALE 1:3 | SIZE A 7 | PRT. NO. | #

D
D

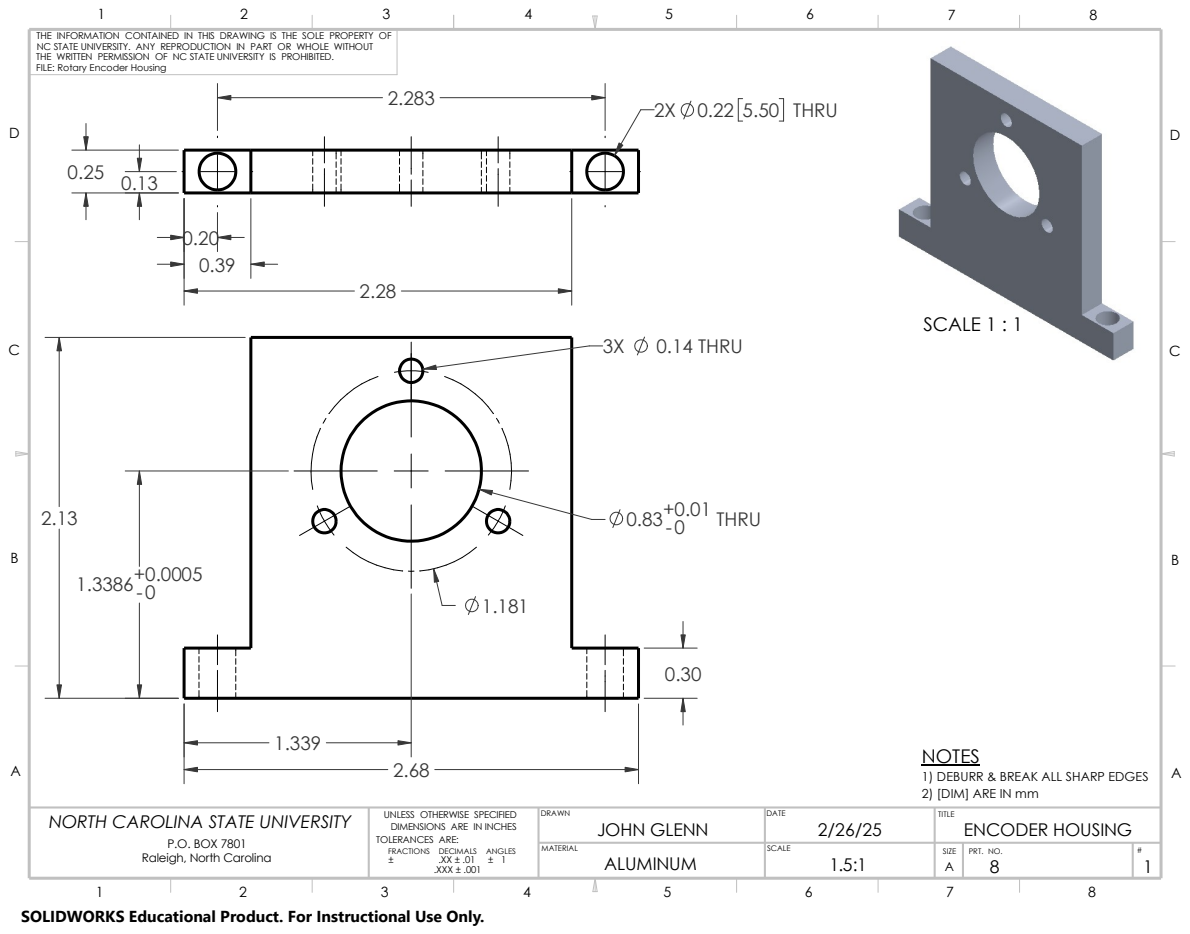
[picture p49: page 8]
SCALE 1 : 1; THRU; 0.14 THRU

THE WRITTEN PERMISSION OF NC STATE UNIVERSITY IS PROHIBITED.
FILE: Rotary Encoder Housing

NOTES
1) DEBURR & BREAK ALL SHARP EDGES
2) [DIM] ARE IN mm

P.O. BOX 7801 | UNLESS OTHERWISE SPECIFIED NORTH CAROLINA STATE UNIVERSITY DIMENSIONS ARE IN INCHES TOLERANCES ARE: FRACTIONS DECIMALS ANGLES | DRAWN JOHN GLENN | DATE 2/26/25 | TITLE ENCODER HOUSING

MATERIAL ALUMINUM | SCALE 1.5:1 | SIZE A 8 | PRT. NO. | #

D
D

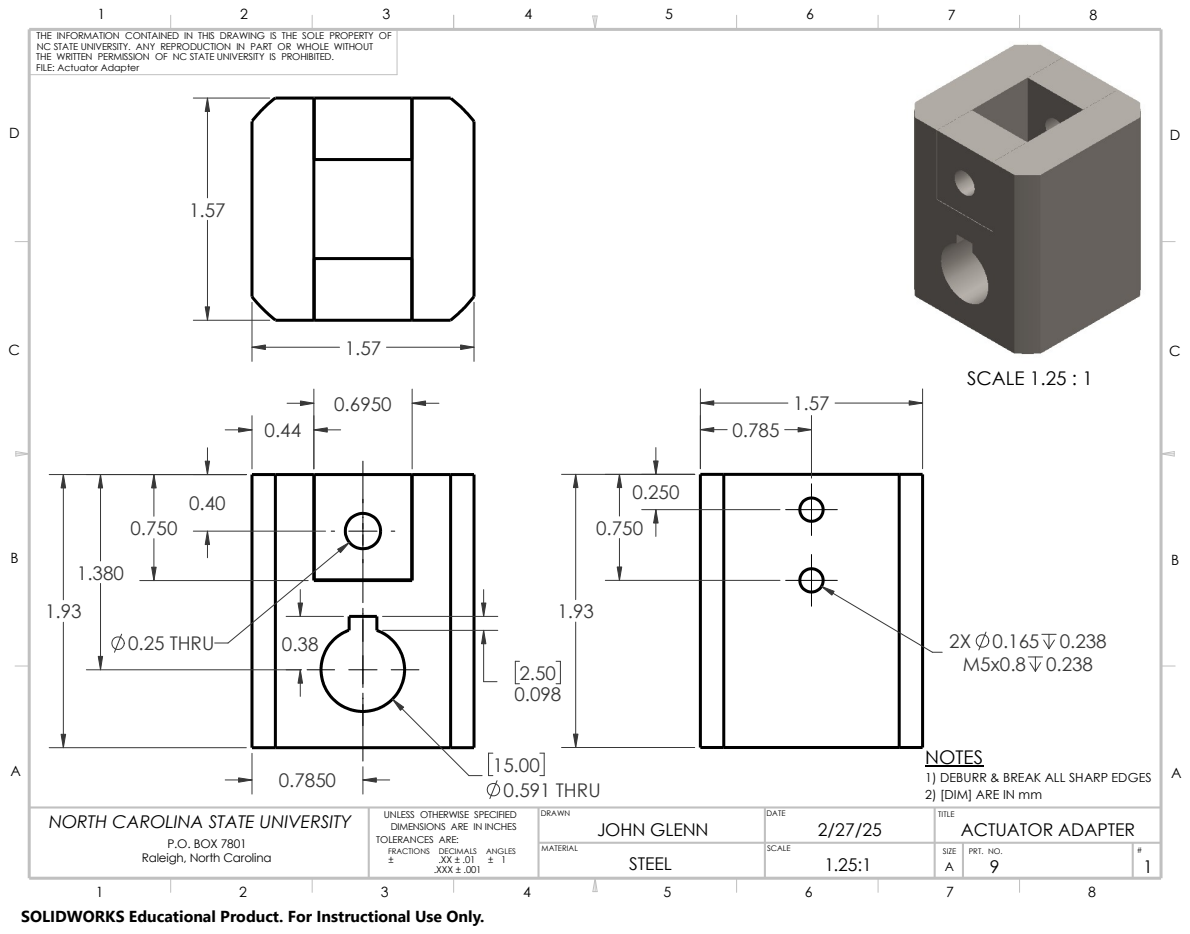
[picture p50: page 9]
15.00 0.591 THRU; 0.25 THRU; SCALE 1.25 : 1

THE WRITTEN PERMISSION OF NC STATE UNIVERSITY IS PROHIBITED.
FILE: Actuator Adapter

NOTES
1) DEBURR & BREAK ALL SHARP EDGES
2) [DIM] ARE IN mm

P.O. BOX 7801 | UNLESS OTHERWISE SPECIFIED NORTH CAROLINA STATE UNIVERSITY DIMENSIONS ARE IN INCHES TOLERANCES ARE: FRACTIONS DECIMALS ANGLES | DRAWN JOHN GLENN | DATE 2/27/25 | TITLE ACTUATOR ADAPTER

MATERIAL | SCALE 1.25:1 | SIZE A 9 | PRT. NO. | #

D
D

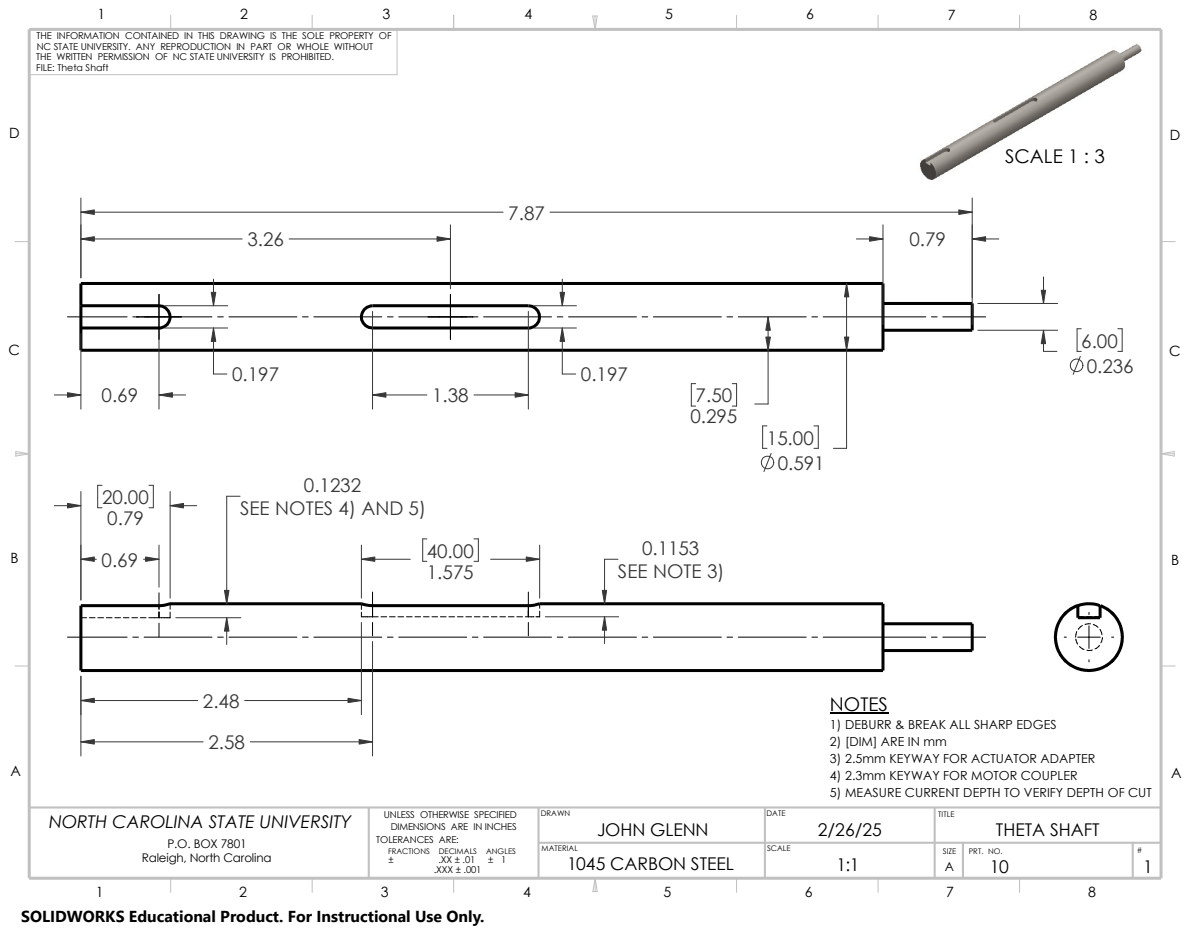
[picture p51: page 10]
SCALE 1 : 3; 0.1153 SEE NOTE 3)

THE WRITTEN PERMISSION OF NC STATE UNIVERSITY IS PROHIBITED.
FILE: Theta Shaft

SEE NOTES 4) AND 5)

NOTES
1) DEBURR & BREAK ALL SHARP EDGES
2) [DIM] ARE IN mm
3) 2.5mm KEYWAY FOR ACTUATOR ADAPTER
4) 2.3mm KEYWAY FOR MOTOR COUPLER
5) MEASURE CURRENT DEPTH TO VERIFY DEPTH OF CUT

P.O. BOX 7801 | UNLESS OTHERWISE SPECIFIED NORTH CAROLINA STATE UNIVERSITY DIMENSIONS ARE IN INCHES TOLERANCES ARE: FRACTIONS DECIMALS ANGLES | DRAWN JOHN GLENN | DATE 2/26/25 | TITLE THETA SHAFT

MATERIAL 1045 CARBON STEEL | SCALE 1:1 | SIZE A 10 | PRT. NO. | #

D
D

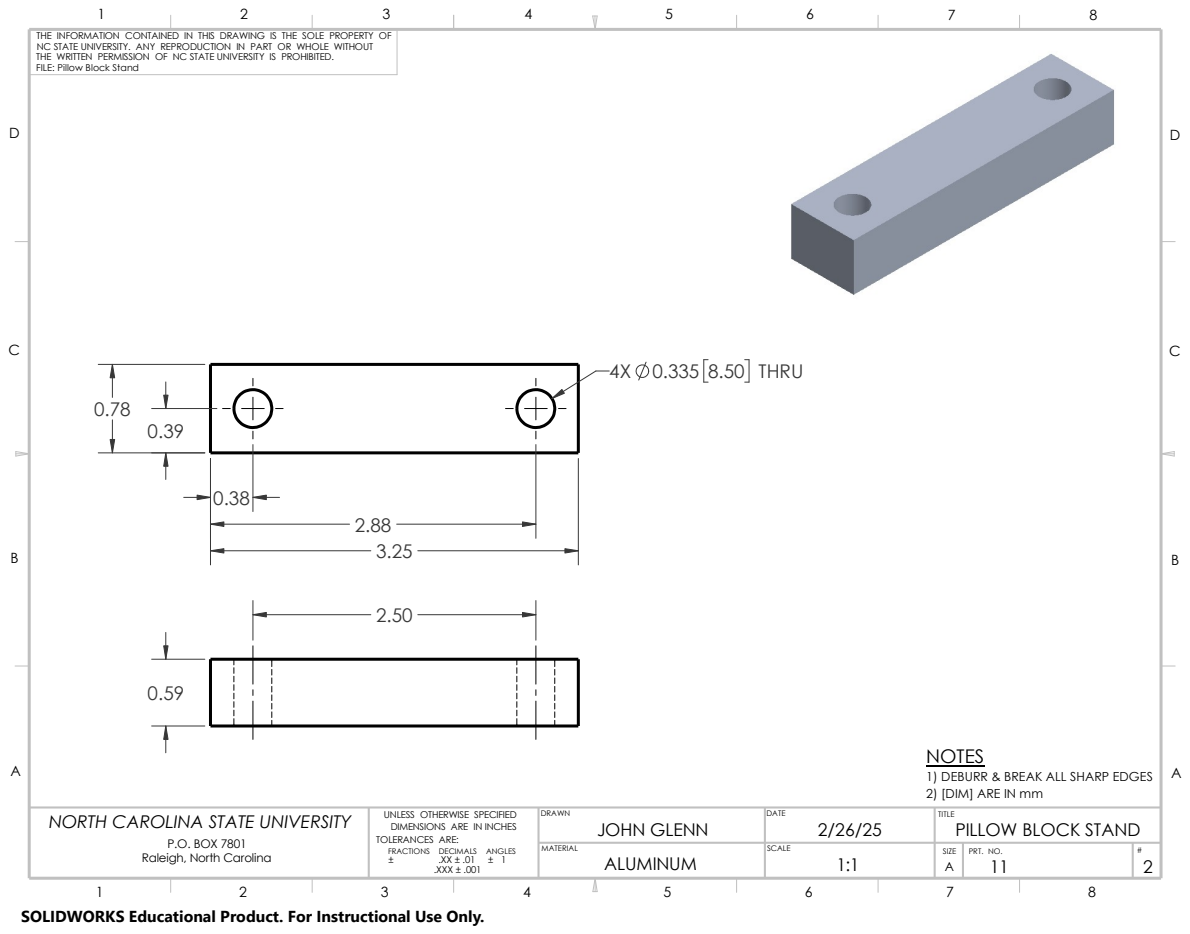
[picture p52: page 11]
THRU

THE WRITTEN PERMISSION OF NC STATE UNIVERSITY IS PROHIBITED.
FILE: Pillow Block Stand

NOTES
1) DEBURR & BREAK ALL SHARP EDGES
2) [DIM] ARE IN mm

P.O. BOX 7801 | UNLESS OTHERWISE SPECIFIED NORTH CAROLINA STATE UNIVERSITY DIMENSIONS ARE IN INCHES TOLERANCES ARE: FRACTIONS DECIMALS ANGLES | DRAWN JOHN GLENN | DATE 2/26/25 | TITLE PILLOW BLOCK STAND

MATERIAL ALUMINUM | SCALE 1:1 | SIZE A 11 | PRT. NO. | # 2

D
D

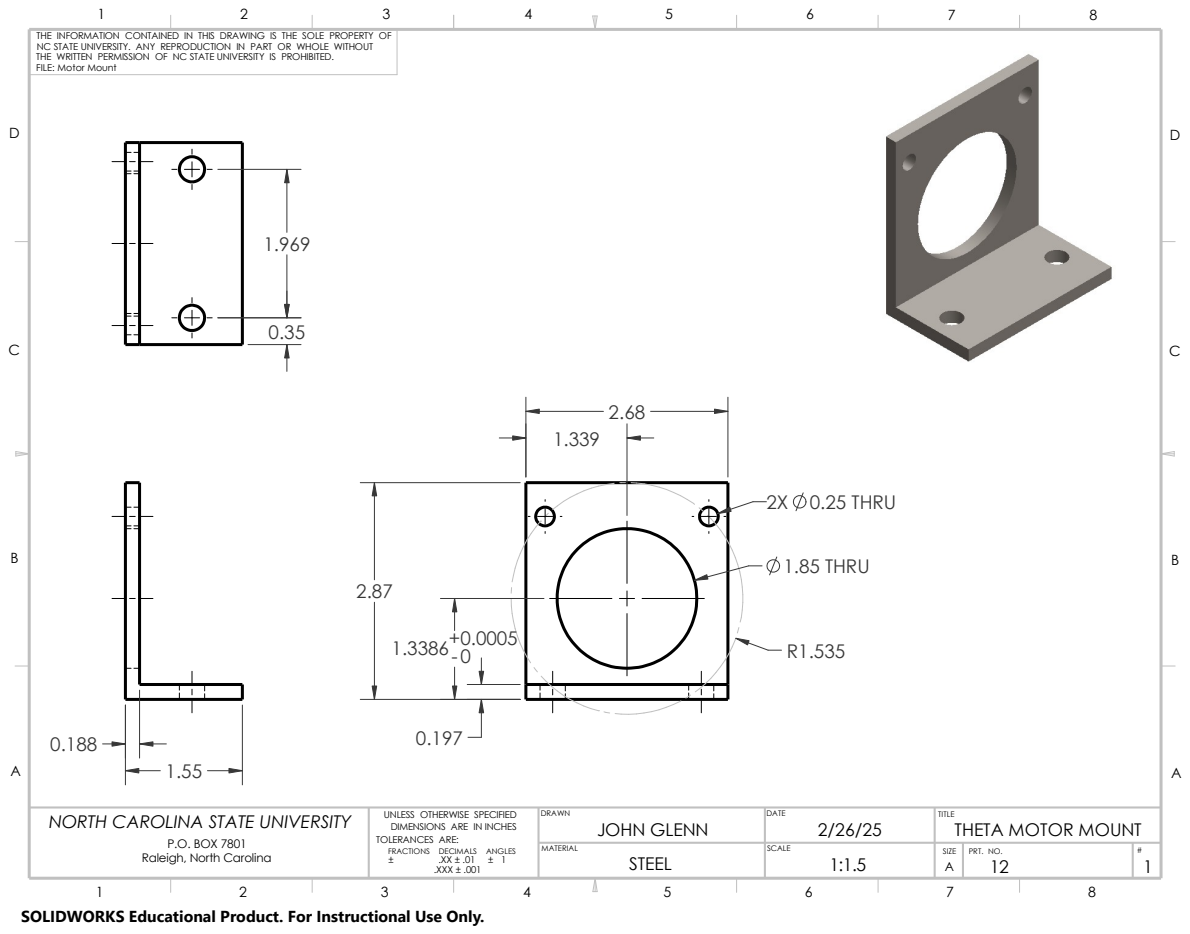
[picture p53: page 12]
2X 0.25 THRU; 1.85 THRU

THE WRITTEN PERMISSION OF NC STATE UNIVERSITY IS PROHIBITED.
FILE: Motor Mount

P.O. BOX 7801 | UNLESS OTHERWISE SPECIFIED NORTH CAROLINA STATE UNIVERSITY DIMENSIONS ARE IN INCHES TOLERANCES ARE: FRACTIONS DECIMALS ANGLES | DRAWN JOHN GLENN | DATE 2/26/25 | TITLE THETA MOTOR MOUNT

MATERIAL | SCALE 1:1.5 | SIZE A 12 | PRT. NO. | #

D
D

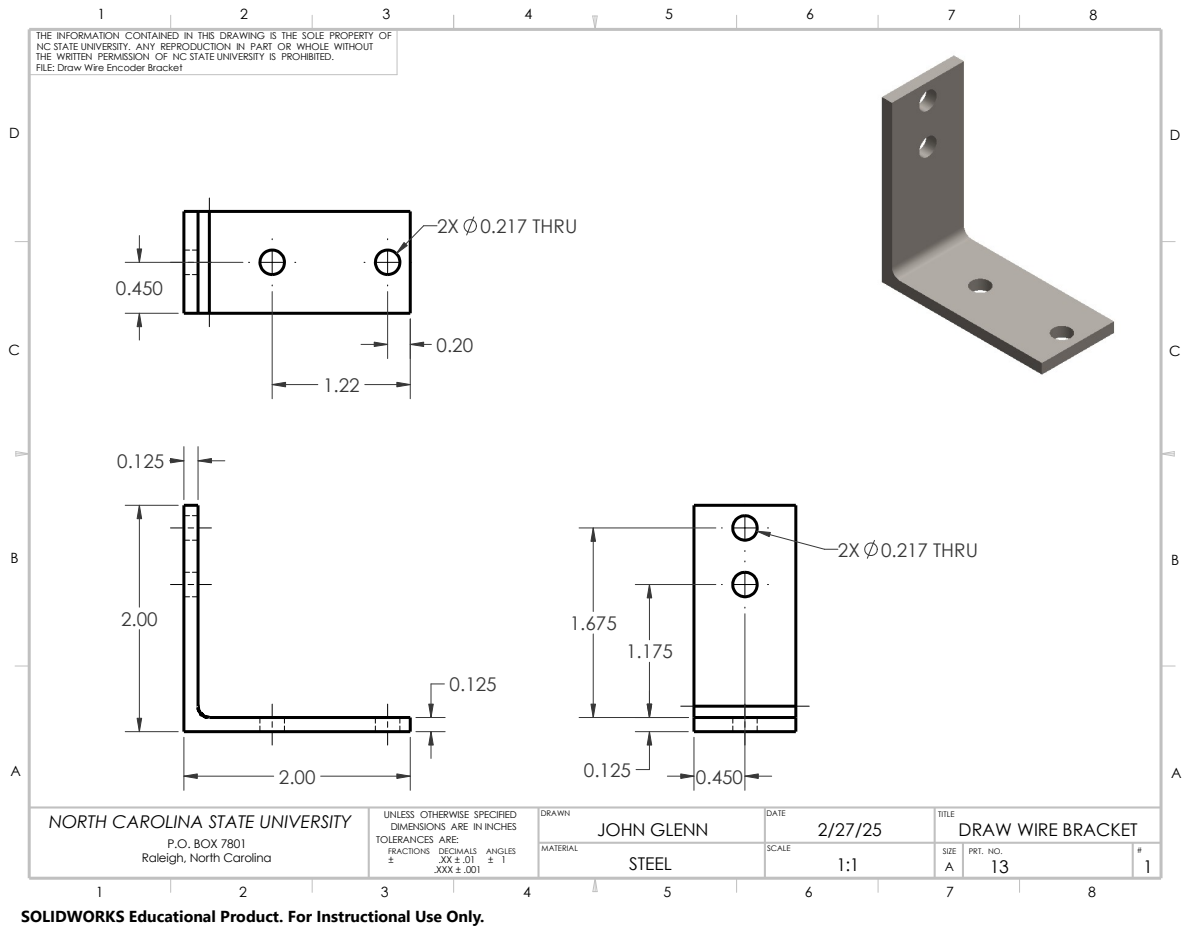
[picture p54: page 13]
2X 0.217 THRU

THE WRITTEN PERMISSION OF NC STATE UNIVERSITY IS PROHIBITED.
FILE: Draw Wire Encoder Bracket

P.O. BOX 7801 | UNLESS OTHERWISE SPECIFIED NORTH CAROLINA STATE UNIVERSITY DIMENSIONS ARE IN INCHES TOLERANCES ARE: FRACTIONS DECIMALS ANGLES | DRAWN JOHN GLENN | DATE 2/27/25 | TITLE DRAW WIRE BRACKET

MATERIAL | SCALE 1:1 | SIZE A 13 | PRT. NO. | #

D
D

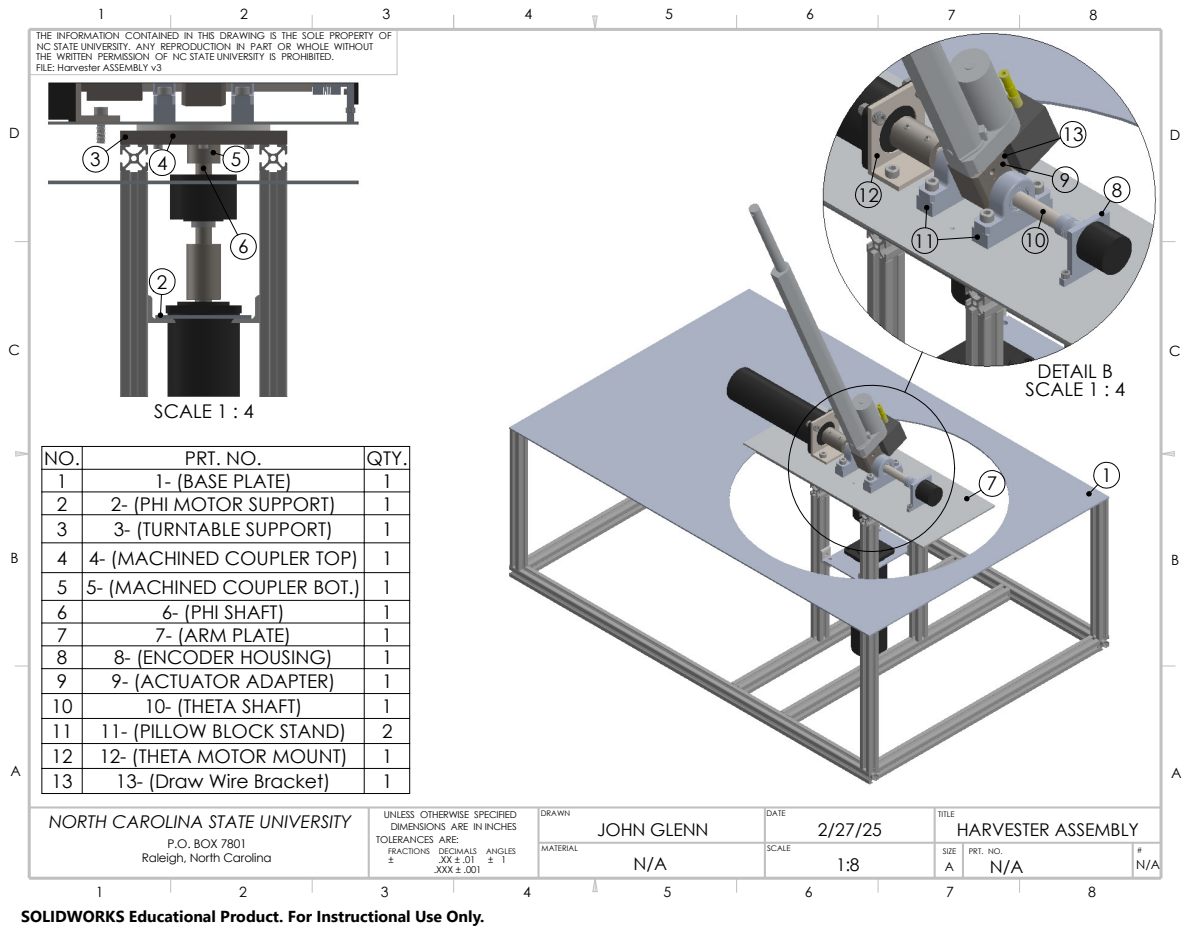
[picture p55: page 14]
SCALE 1 : 4; DETAIL B SCALE 1 : 4

THE WRITTEN PERMISSION OF NC STATE UNIVERSITY IS PROHIBITED.
FILE: Harvester ASSEMBLY v3

NO. | PRT. NO. | QTY.
1 | 1- (BASE PLATE) | 1
2 | 2- (PHI MOTOR SUPPORT) | 1
3 | 3- (TURNTABLE SUPPORT) | 1
4 | 4- (MACHINED COUPLER TOP) | 1
5 | 5- (MACHINED COUPLER BOT.) | 1
6 | 6- (PHI SHAFT) | 1
7 | 7- (ARM PLATE) | 1
8 | 8- (ENCODER HOUSING) | 1
9 | 9- (ACTUATOR ADAPTER) | 1
10 | 10- (THETA SHAFT) | 1
11 | 11- (PILLOW BLOCK STAND) | 2
12 | 12- (THETA MOTOR MOUNT) | 1
13 | 13- (Draw Wire Bracket) | 1

P.O. BOX 7801 | UNLESS OTHERWISE SPECIFIED NORTH CAROLINA STATE UNIVERSITY DIMENSIONS ARE IN INCHES TOLERANCES ARE: FRACTIONS DECIMALS ANGLES | DRAWN JOHN GLENN | DATE 2/27/25 | TITLE HARVESTER ASSEMBLY

MATERIAL N/A | SCALE 1:8 | SIZE A N/A | PRT. NO. | # N/A
