johnglennII/Tomato-Harvester/(commit log)

2026-05-14 Revise README with project details and improved visuals
    Updated project overview to include details about the LQR controller and Kalman Filter. Enhanced visuals with alt text for images.
2026-05-14 Add control system demo video and assembly image
    Added a control system demonstration video and an image of the actual assembly.
2026-05-15 cad files up
    [15mm Shaft Coupler.SLDPRT, 20mm Rounded Key.SLDPRT, 2525 Length=BottomPlateX.SLDPRT, 2525 Length=BottomPlateZ.SLDPRT, 2525 Length=Height.SLDPRT, 2525 Length=SupportH.SLDPRT, 2525 Length=SupportZ.SLDPRT, 2820T56_Dry-Running Mounted Sleeve Bearing.SLDPRT]
2026-05-16 cad stuff
    [2525 Length=BottomPlateX.SLDPRT, 2525 Length=BottomPlateZ.SLDPRT, 2525 Length=Height.SLDPRT, 2525 Length=SupportH.SLDPRT, 2525 Length=SupportZ.SLDPRT, Arm Plate v2.SLDPRT, Bottom Plate v2.SLDPRT, Motor Mount.SLDPRT]
2026-05-16 Improve parameter display and add .gitignore
    Add .gitignore to ignore *.asv files. In SystemID.m introduce a Labels array and replace raw disp(estimatedParams) calls with labeled fprintf loops to print parameter names and values. Remove a leftover "CHANGE" note in the K_r1 comment and clean up a redundant disp call. These changes improve readability of estimated parameter output and tidy the file.
2026-05-16 created stl of cad assembly
2026-05-16 fixed cs on cad assembly stl
2026-05-16 fixed coordinate sys of cad assembly stl
    helps when you actually select the new coordinate system when exporting
2026-05-16 deleted unused cad files
    [15mm Shaft Coupler.SLDPRT, 2525 Length=BottomPlateX.SLDPRT, 2525 Length=BottomPlateZ.SLDPRT, 2525 Length=Height.SLDPRT, 2525 Length=SupportH.SLDPRT, 2525 Length=SupportZ.SLDPRT, 4040 Length=BottomPlateX.SLDPRT, 4040 Length=BottomPlateZ.SLDPRT]
2026-05-20 Update CAD drawing, add PNG, remove .figs
    Update binary CAD shop drawing (cad/shop-drawings/tomato_harvester_shop_dwgs.SLDDRW), add new assembly image media/cad_assembly_dwg.png, and remove legacy FIG files (media/good data.fig, media/presentation fig.fig) to clean up outdated assets.
